georgysb/ZEUS/photo/CPU_bot.jpg

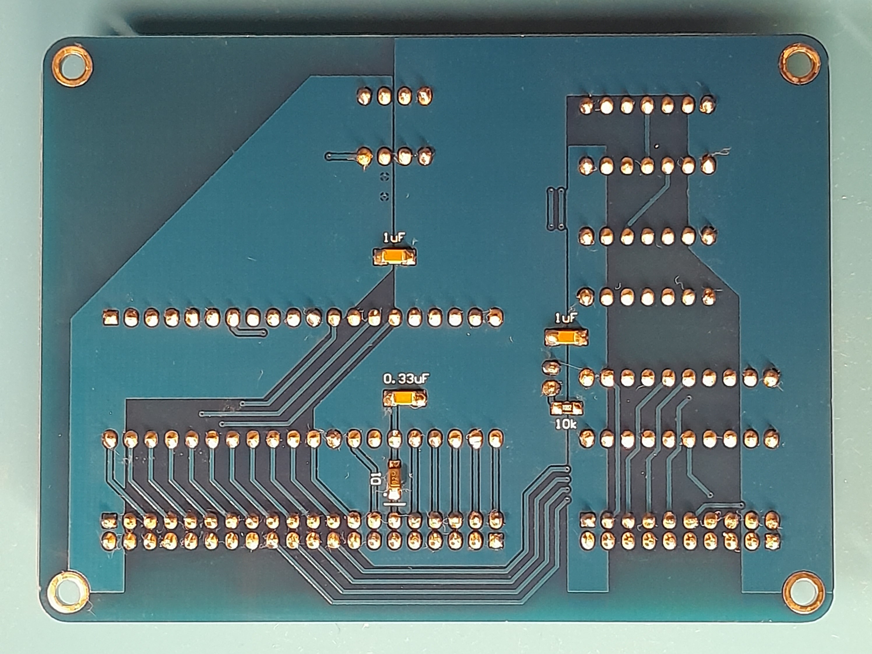
photo/CPU_bot.jpg
