georgysb/ZEUS/photo/backboard_top.jpg

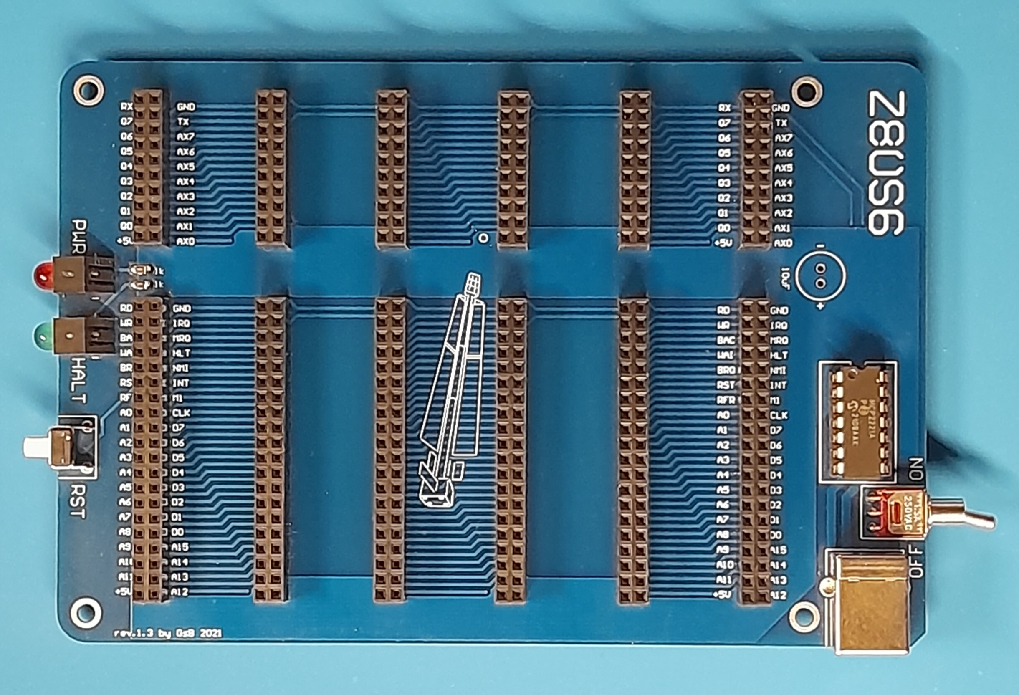
photo/backboard_top.jpg
