georgysb/ZEUS/design/readme.txt

ZEUS system supports up to 4 GPIO modules, provided A2, A3 ports range select jumpers are set differently.

Back board coupler is used to join 2 ZEUS6 back boards into 11 slots system.
