georgysb/ZEUS/ZEUS_monitor/readme.txt

Arduino MEGA code that writes ZEUS Monitor to AT28C256 EEPROM via Arduino MEGA EEPROM programmer shield https://www.tindie.com/products/georgysb/eeprom-dip-28-programmer-shield-for-arduino-mega/.

Be advised, the code is organized in blocks that one can write separately by commenting/decommenting corresponding Arduino code lines (779-804).
