georgysb/ZEUS/design/ZEUS_module_dimensions.png

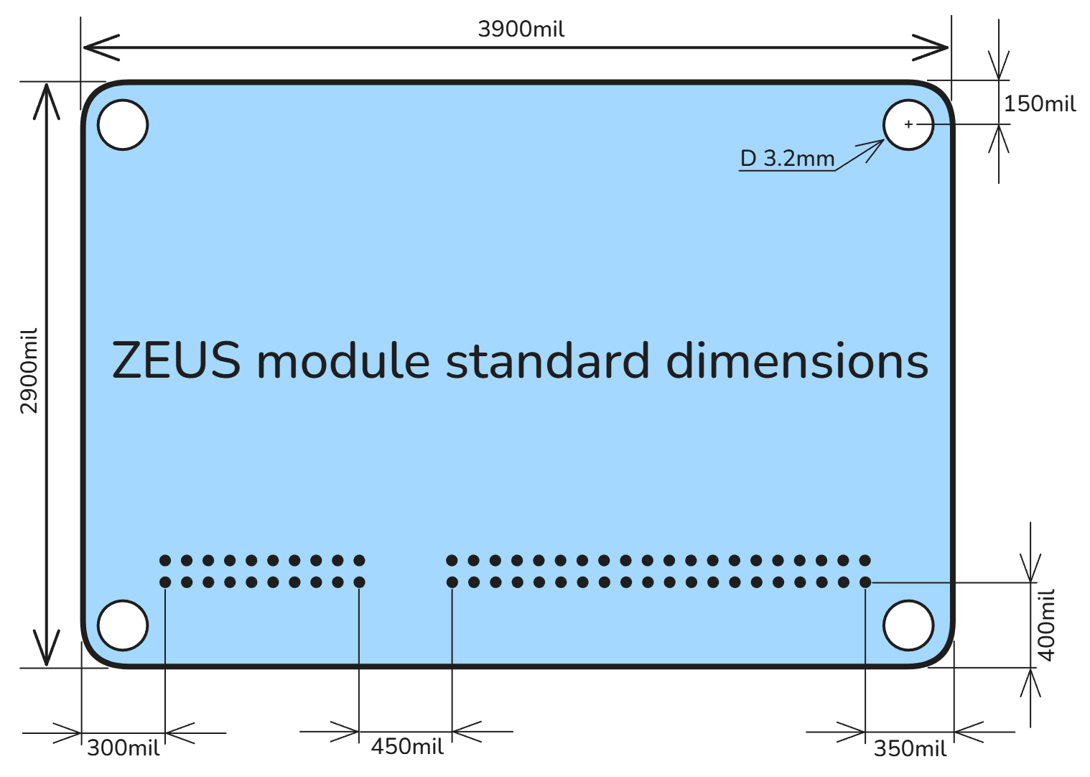
design/ZEUS_module_dimensions.png
