georgysb/ZEUS/photo/backboard_bot.jpg

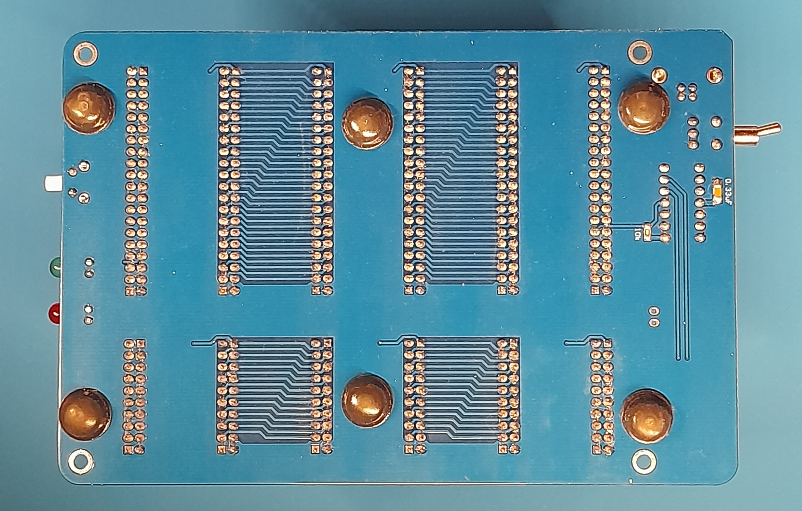
photo/backboard_bot.jpg
