georgysb/ZEUS/photo/coupler.jpg

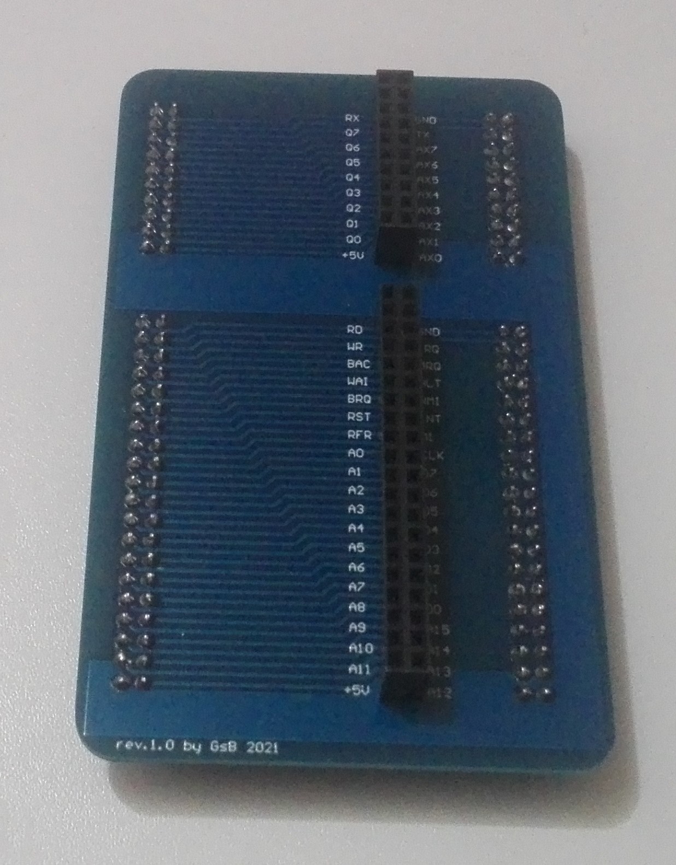
photo/coupler.jpg
