georgysb/ZEUS/photo/CPU_top.jpg

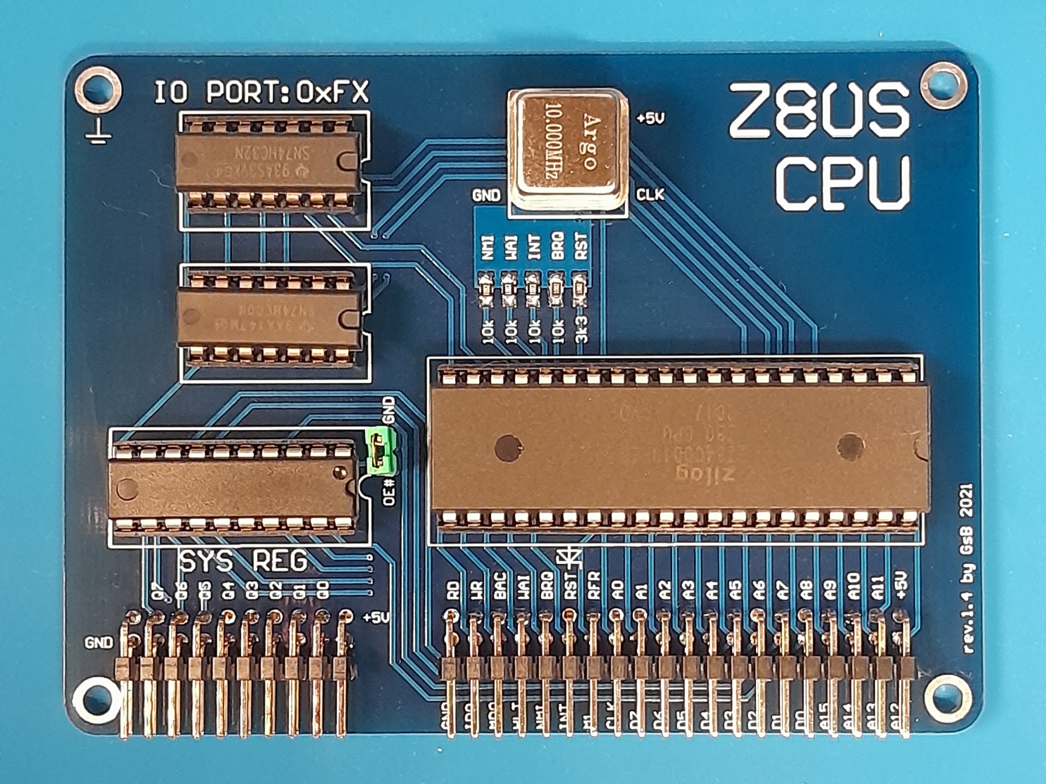
photo/CPU_top.jpg
