georgysb/ZEUS/photo/GPIO_bot.jpg

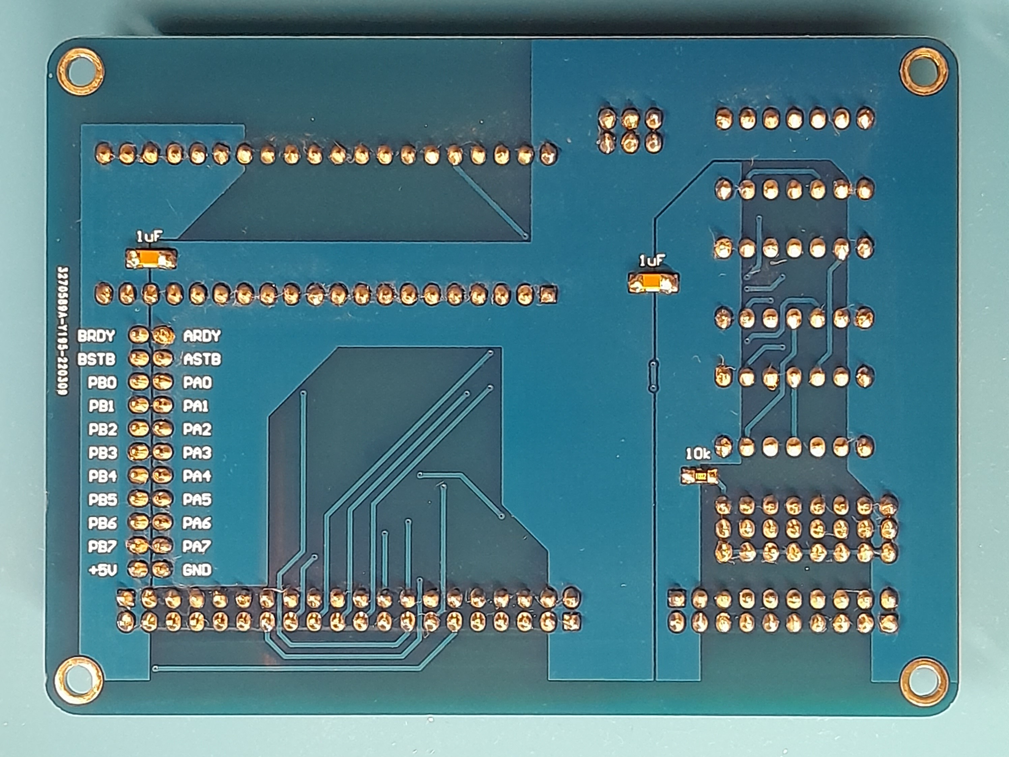
photo/GPIO_bot.jpg
