georgysb/ZEUS/photo/gpio_header.jpg

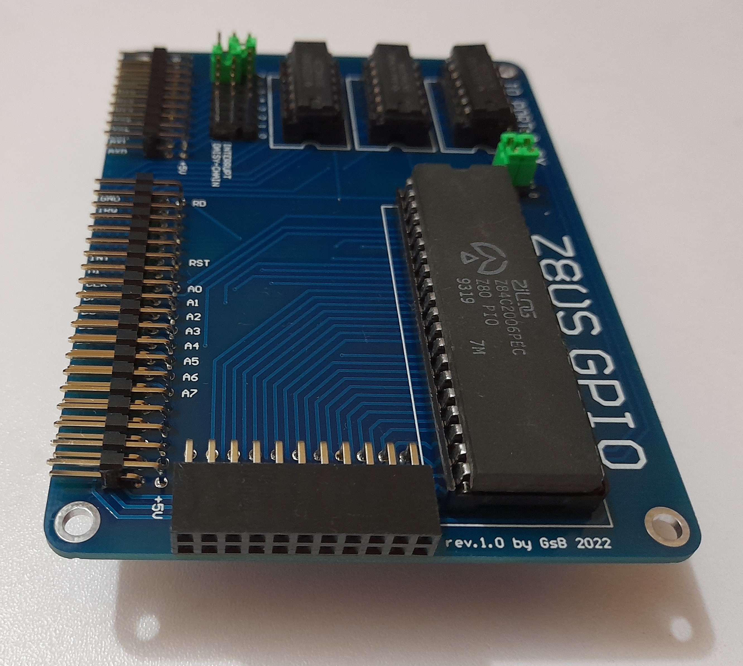
photo/gpio_header.jpg
