georgysb/ZEUS/photo/GPIO_top.jpg

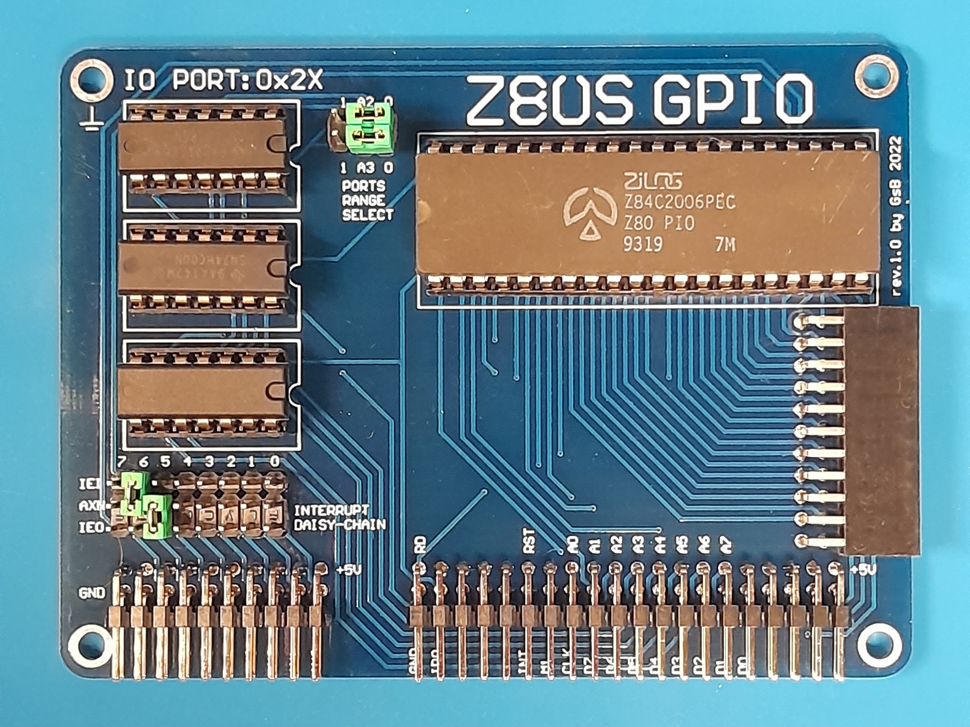
photo/GPIO_top.jpg
