georgysb/ZEUS/photo/MEM128_bot.jpg

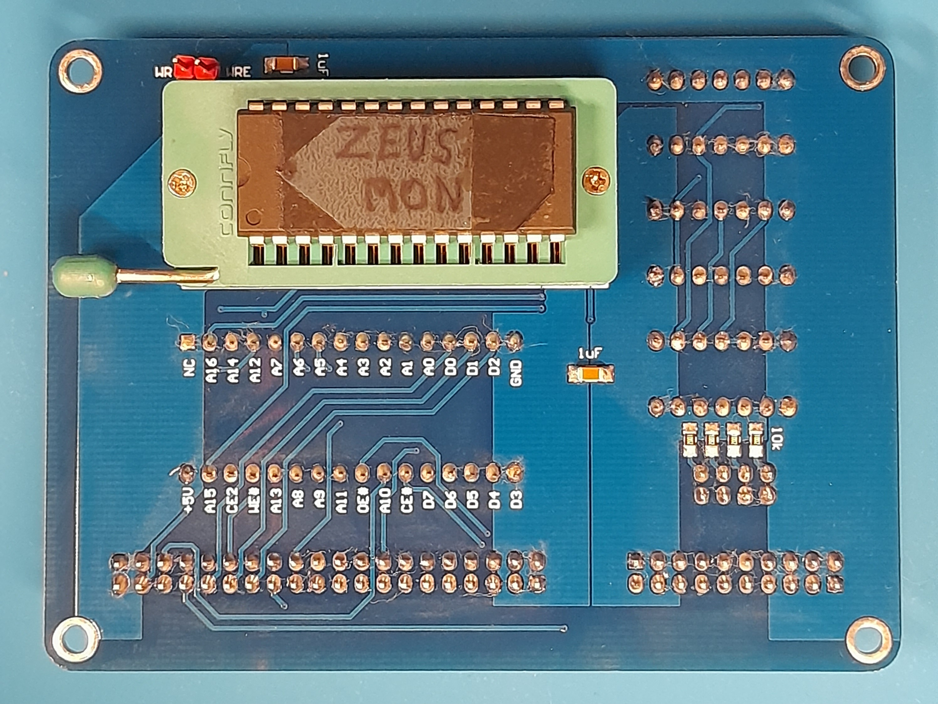
photo/MEM128_bot.jpg
