georgysb/ZEUS/photo/MEM128_top.jpg

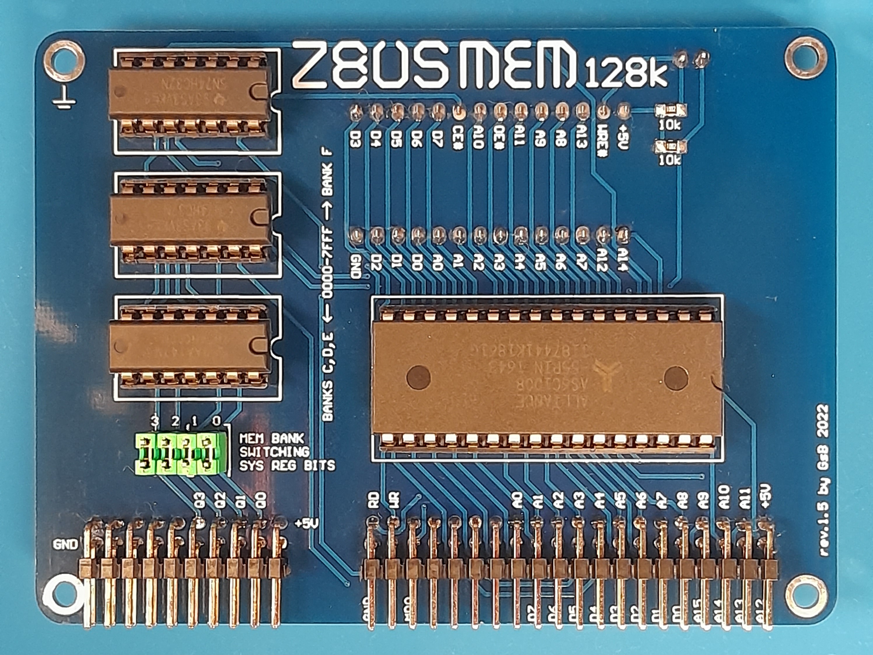
photo/MEM128_top.jpg
