georgysb/ZEUS/photo/MEM512_top.jpg

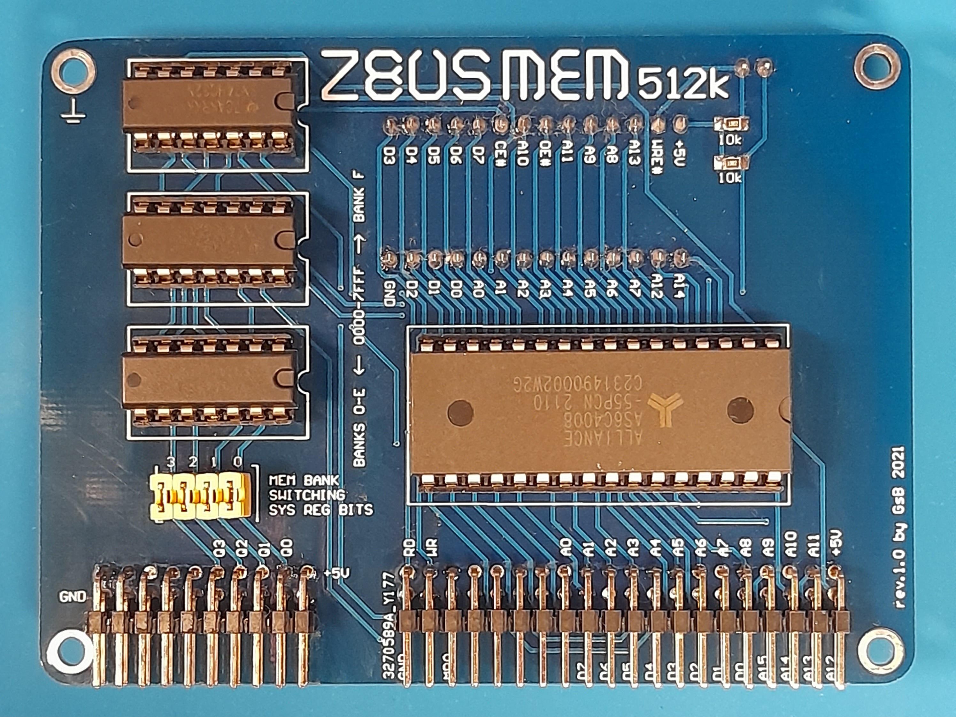
photo/MEM512_top.jpg
