georgysb/ZEUS/photo/PIO_bot.jpg

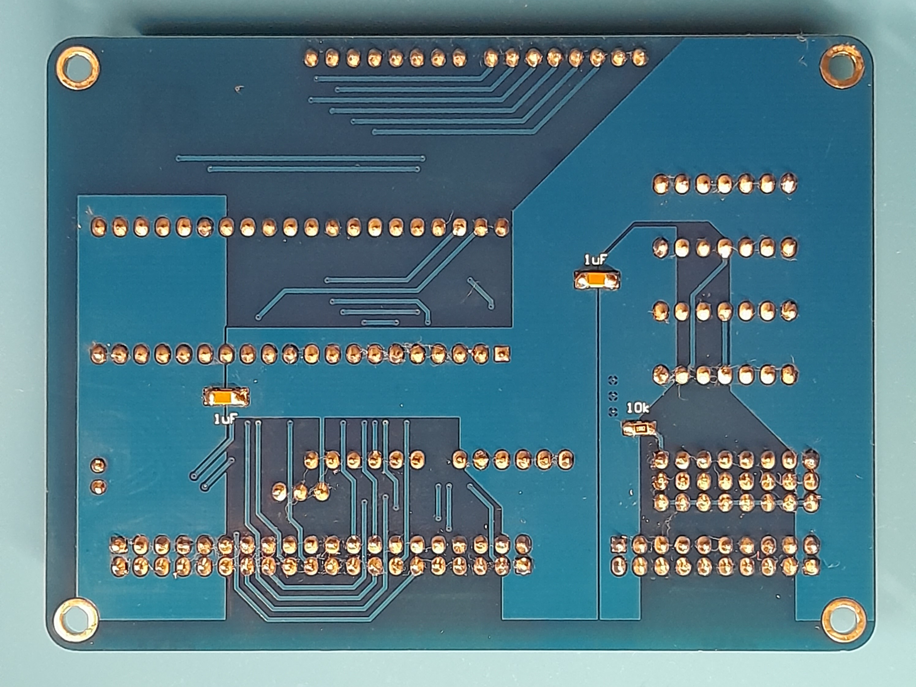
photo/PIO_bot.jpg
