georgysb/ZEUS/photo/PIO_top.jpg

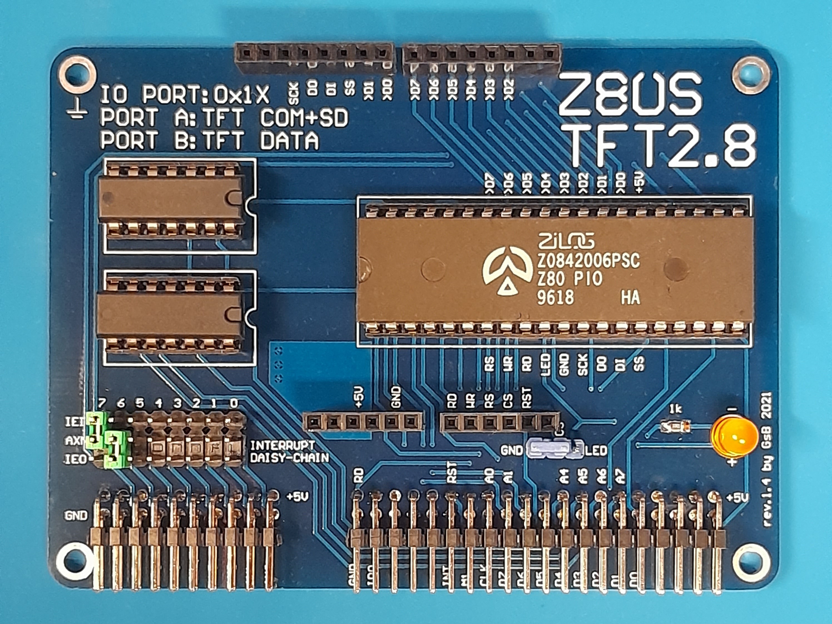
photo/PIO_top.jpg
