georgysb/ZEUS/photo/prog_side.jpg

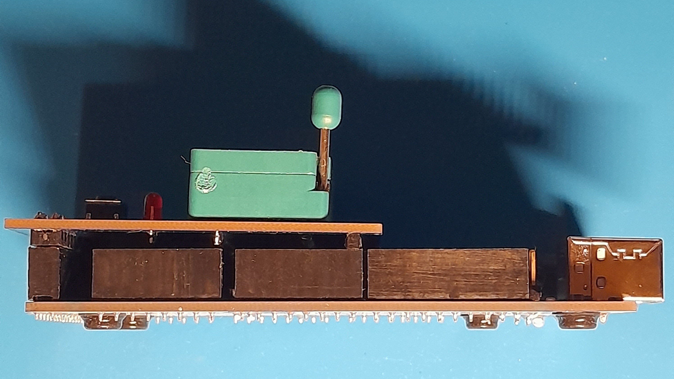
photo/prog_side.jpg
