georgysb/ZEUS/photo/prog_top.jpg

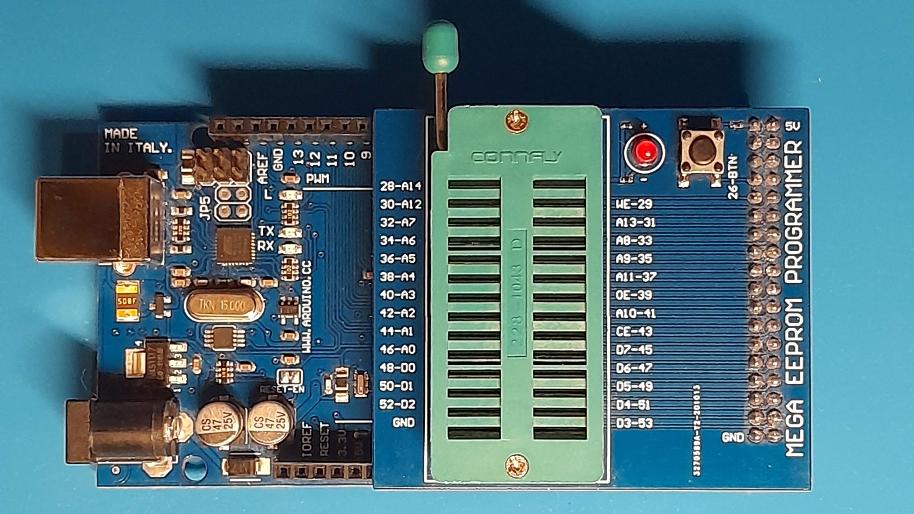
photo/prog_top.jpg
