georgysb/ZEUS/photo/SIO_bot.jpg

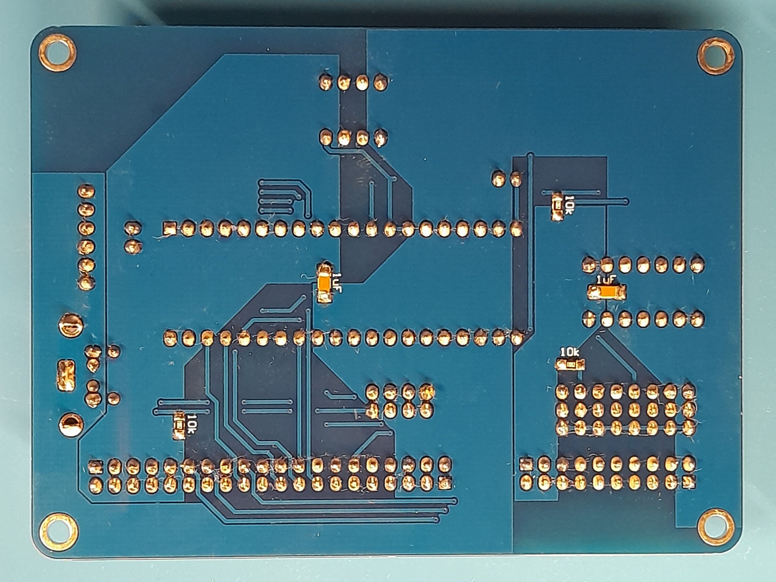
photo/SIO_bot.jpg
