georgysb/ZEUS/photo/SIO_top.jpg

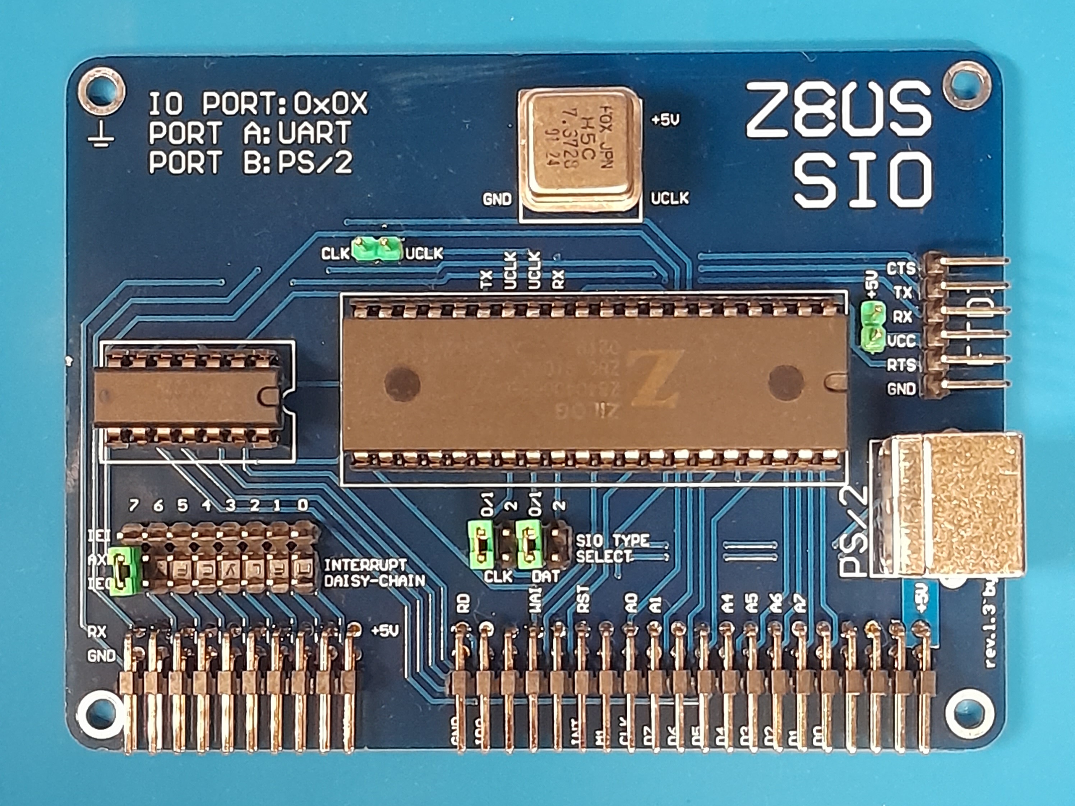
photo/SIO_top.jpg
