georgysb/ZEUS/photo/TFT_bot.jpg

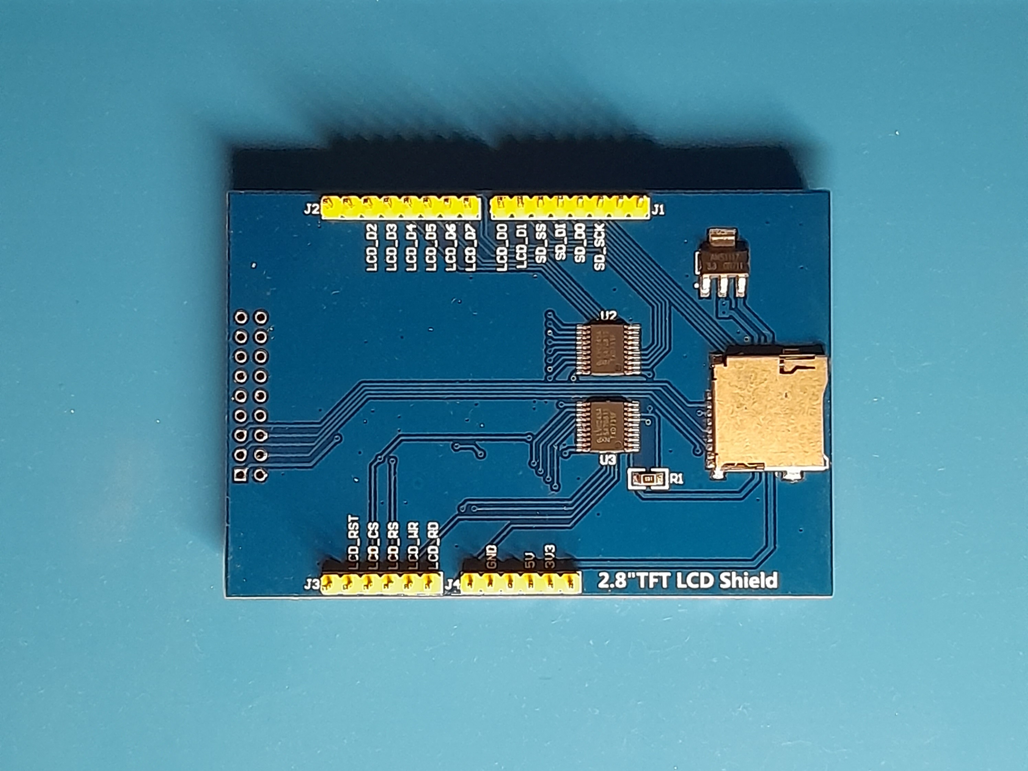
photo/TFT_bot.jpg
