georgysb/ZEUS/photo/TFT_top.jpg

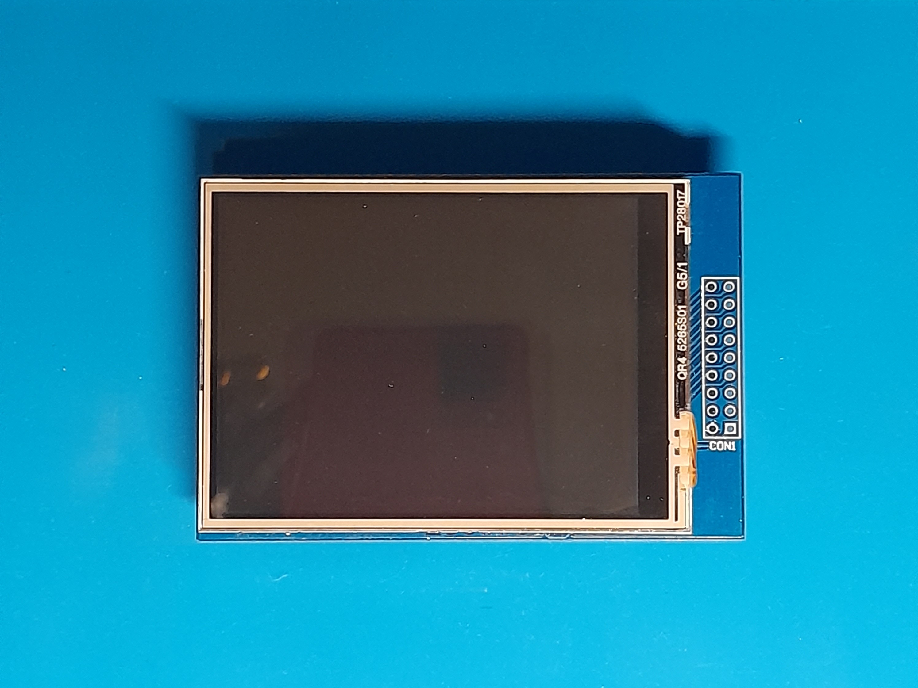
photo/TFT_top.jpg
