georgysb/ZEUS/photo/zeus+gpio_function.jpg

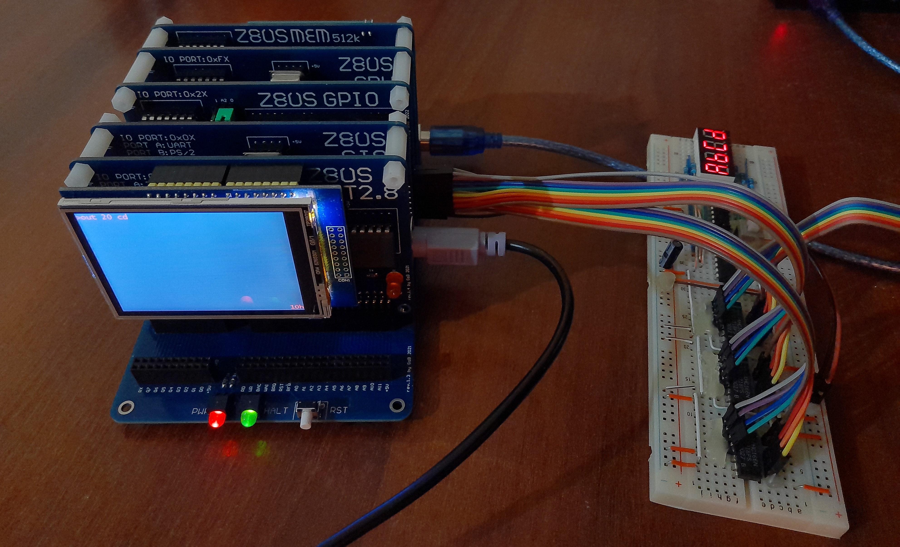
photo/zeus+gpio_function.jpg
