georgysb/ZEUS/photo/zeus_back.jpg

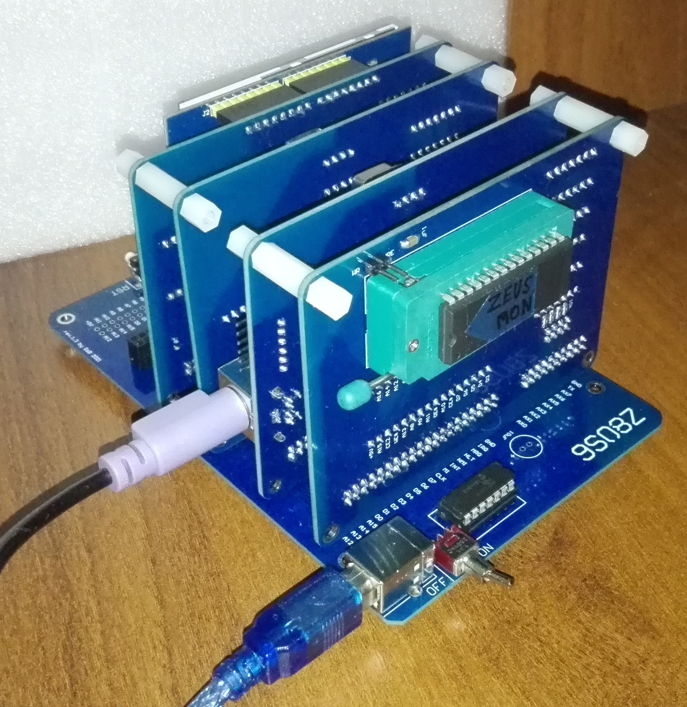
photo/zeus_back.jpg
