georgysb/ZEUS/photo/zeus_front.jpg

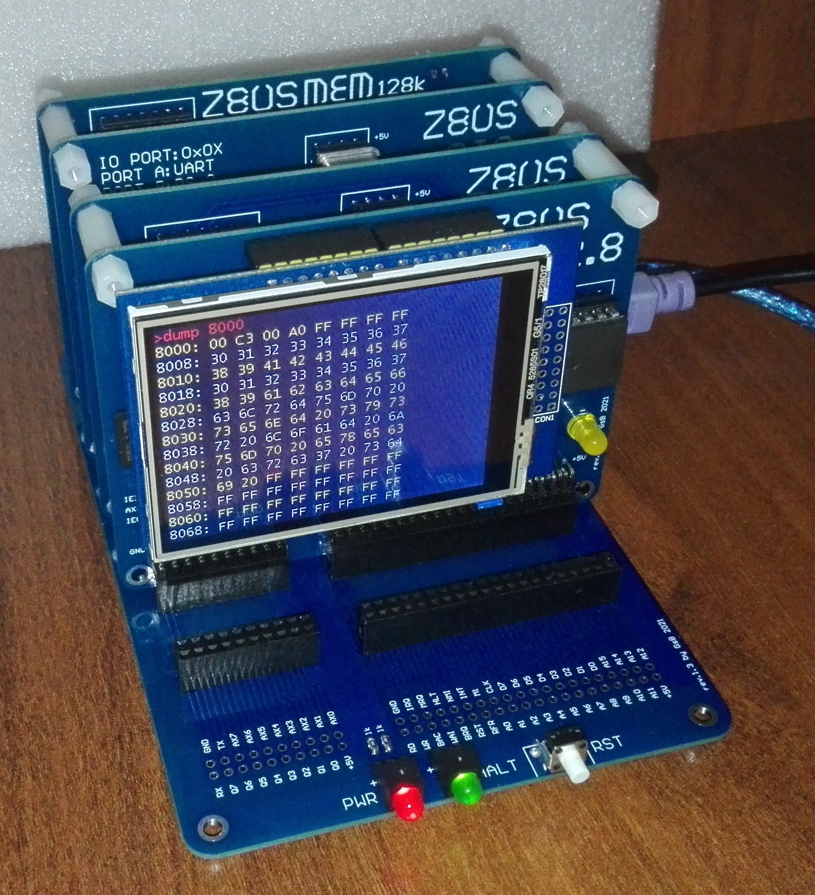
photo/zeus_front.jpg
