georgysb/ZEUS/photo/zeus_highZ.jpg

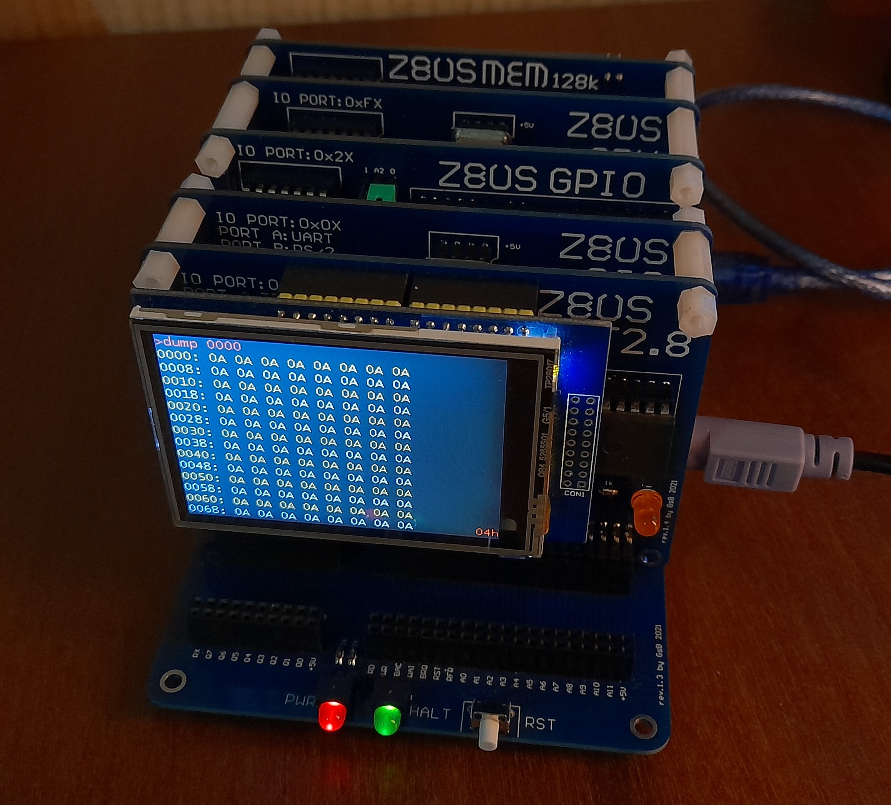
photo/zeus_highZ.jpg
