georgysb/ZEUS/photo/zeus_side.jpg

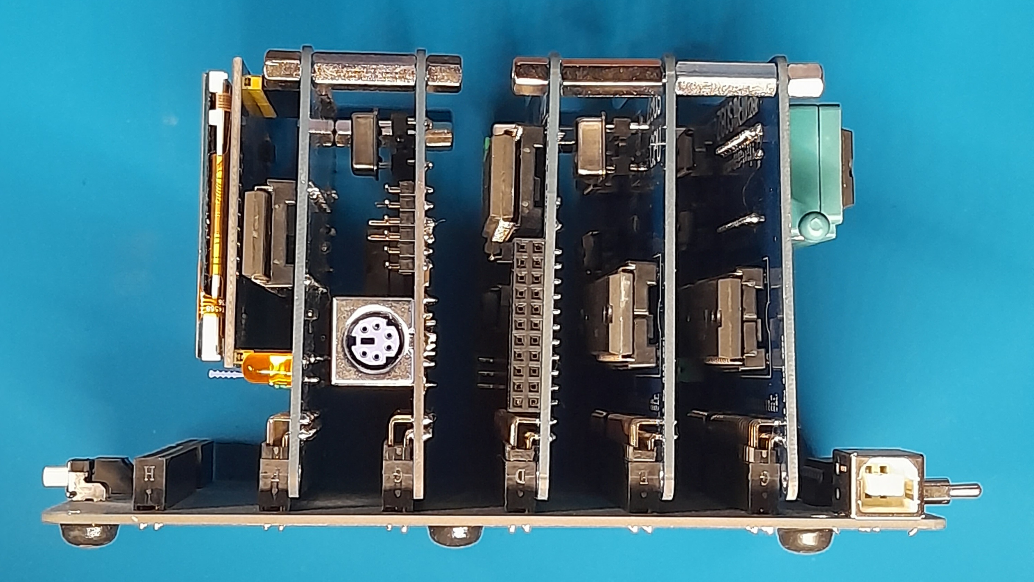
photo/zeus_side.jpg
