georgysb/ZEUS/photo/zeus_top.jpg

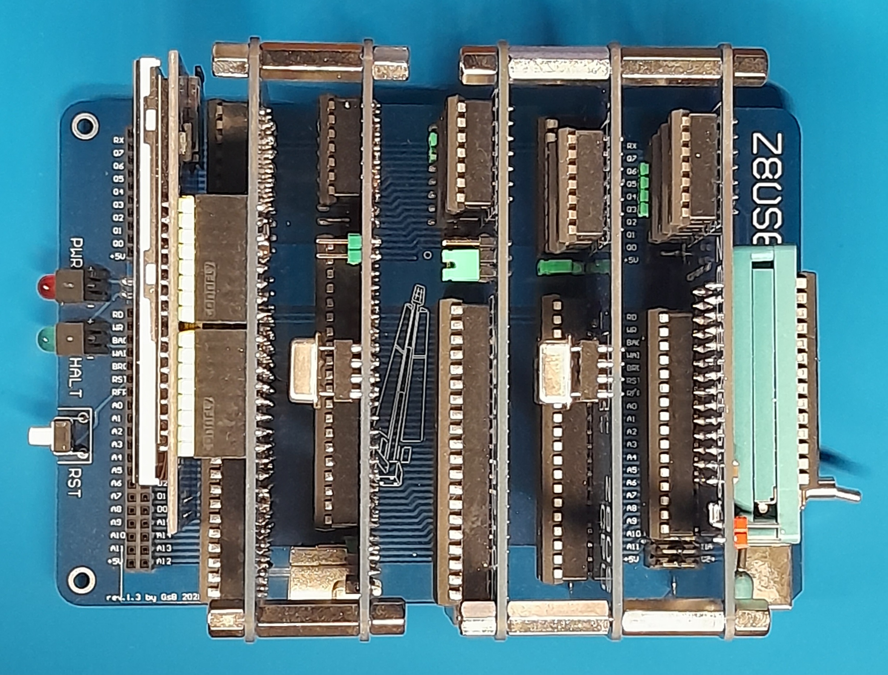
photo/zeus_top.jpg
