georgysb/ZEUS/zeus_BOM.txt

----------------------------------ZEUS6 (backboard)
6x	PBD-40 header
6x	PBD-20 header
1x	USB socket (type B)
1x	SPDT switch (SMTS-102-2C3)
1x	Tact switch R (1-1825027-7)
1x	LED R red (L-1503CB/1ID)
1x	LED R green (L-1503CB/1GD)
1x	dil-14 narrow socket
1x	electrolytic capacitor 10uF (optional)
1x	SMD capacitor 1uF(1206)
1x	SMD resistor 10k(0805)
2x	SMD resistor 1k(0805)
6x	rubber foot

1x	MCP2221A (USB-UART bridge) dip-14

----------------------------------ZEUS CPU (module)
1x	PLD-40R header
1x	PLD-20R header
1x	dil-40 wide socket
1x	dil-20 narrow socket
2x	dil-14 narrow socket
1x	dil-8 narrow collet socket (for quartz generator)
1x	PLS-2 (jumper)
3x	SMD capacitor 1uF(1206)
6x	SMD resistor 10k(0805)
1x	SMD shottky diod

1x	Z84C0010PEG (CPU) dip-40
1x	DM74LS374N (flip-flop) dip-20
1x	SN74HC32N (OR gate) dip-14
1x	SN74HC00N (NAND gate) dip-14
1x	10MHz (clock generator) dil-8

----------------------------------ZEUS MEM128k/512k (module)
1x	PLD-40R header
1x	PLD-20R header
1x	ZIF-28 wide socket (DS1043-280G Connfly)
1x	dil-32 wide socket
3x	dil-14 narrow socket
1x	PLS-2 (jumper)
1x	PLD-8 (jumper header)
2x	SMD capacitor 1uF(1206)
6x	SMD resistor 10k(0805)

1x	AT28C256-15PU (EEPROM 32kB) dip-28 (or FM1808-70-P for 10MHz in situ write capability)
1x	AS6C1008/AS6C4008 (SRAM 128k/512k) dip-32
2x	SN74HC32N (OR gate) dip-14
1x	SN74HC00N (NAND gate) dip-14

----------------------------------ZEUS SIO (module)
1x	PLD-40R header
1x	PLD-20R header
1x	dil-40 wide socket
1x	dil-14 narrow socket
1x	dil-8 narrow collet socket (for quartz generator)
2x	PLS-2 (jumper)
1x	PLD-8 (jumper header)
1x	PLD-16 (jumper header)
1x	PLS-8 (jumper header)
1x	PLS-6R(FTDI header)
2x	SMD capacitor 1uF(1206)
3x	SMD resistor 10k(0805)
1x	PS/2 socket

1x	Z84C4006PEC (SIO) dip-40
1x	SN74HC32N (OR gate) dip-14
1x	7.3728MHz (clock generator) dil-8

----------------------------------ZEUS TFT2.8 (module)
1x	PLD-40R header
1x	PLD-20R header
1x	dil-40 wide socket
2x	dil-14 narrow socket
1x	PLD-16 (jumper header)
1x	PLS-8 (jumper header)
1x	PLS-3 (jumper header)
2x	PBS-8 (TFT shield header)
2x	PBS-6 (TFT shield header)
1x	LED orange
2x	SMD capacitor 1uF(1206)
1x	SMD resistor 10k(0805)
1x	SMD resistor 1k(0805)

1x	Z0842006PSC (PIO) dip-40
1x	SN74HC32N (OR gate) dip-14
1x	SN74HC00N (NAND gate) dip-14
1x	ARDUINO UNO SHIELD TFT2.8" 320x240 (ILI9341)

----------------------------------ZEUS GPIO (module)
1x	PLD-40R header
1x	PLD-20R header
1x	PBD-22R header
1x	dil-40 wide socket
3x	dil-14 narrow socket
1x	PLD-16 (jumper header)
1x	PLS-8 (jumper header)
1x	PLD-6 (jumper header)
2x	SMD capacitor 1uF(1206)
1x	SMD resistor 10k(0805)

1x	Z0842006PSC (PIO) dip-40
1x	SN74HC32N (OR gate) dip-14
1x	SN74HC00N (NAND gate) dip-14
1x	SN74HC86N (XOR gate) dip-14

----------------------------------EEPROM-28pin Arduino MEGA programmer shield
1x	ZIF-28 wide socket (DS1043-280G Connfly)
1x	LED red
1x	Tact switch SMD 6х6мм
1x	SMD resistor 10k(0805)
1x	SMD resistor 1k(0805)

----------------------------------ZEUS coupler
1x	PBD-40 header
1x	PBD-20 header
2x	PLD-40 header (straight)
2x	PLD-20 header (straight)

----------------------------------MISC
10x	jumper 6mm
1x	jumper 13.7mm blue
1x	jumper 13.7mm red

4x	M3 spacer M-F 15mm
2x	M3 spacer F-F 20mm
4x	M3 spacer M-F 6mm
4x	M3 spacer F-F 6mm
