georgysb/ZEUS/schematics/zeus backboard schem.pdf

+5V

## GND

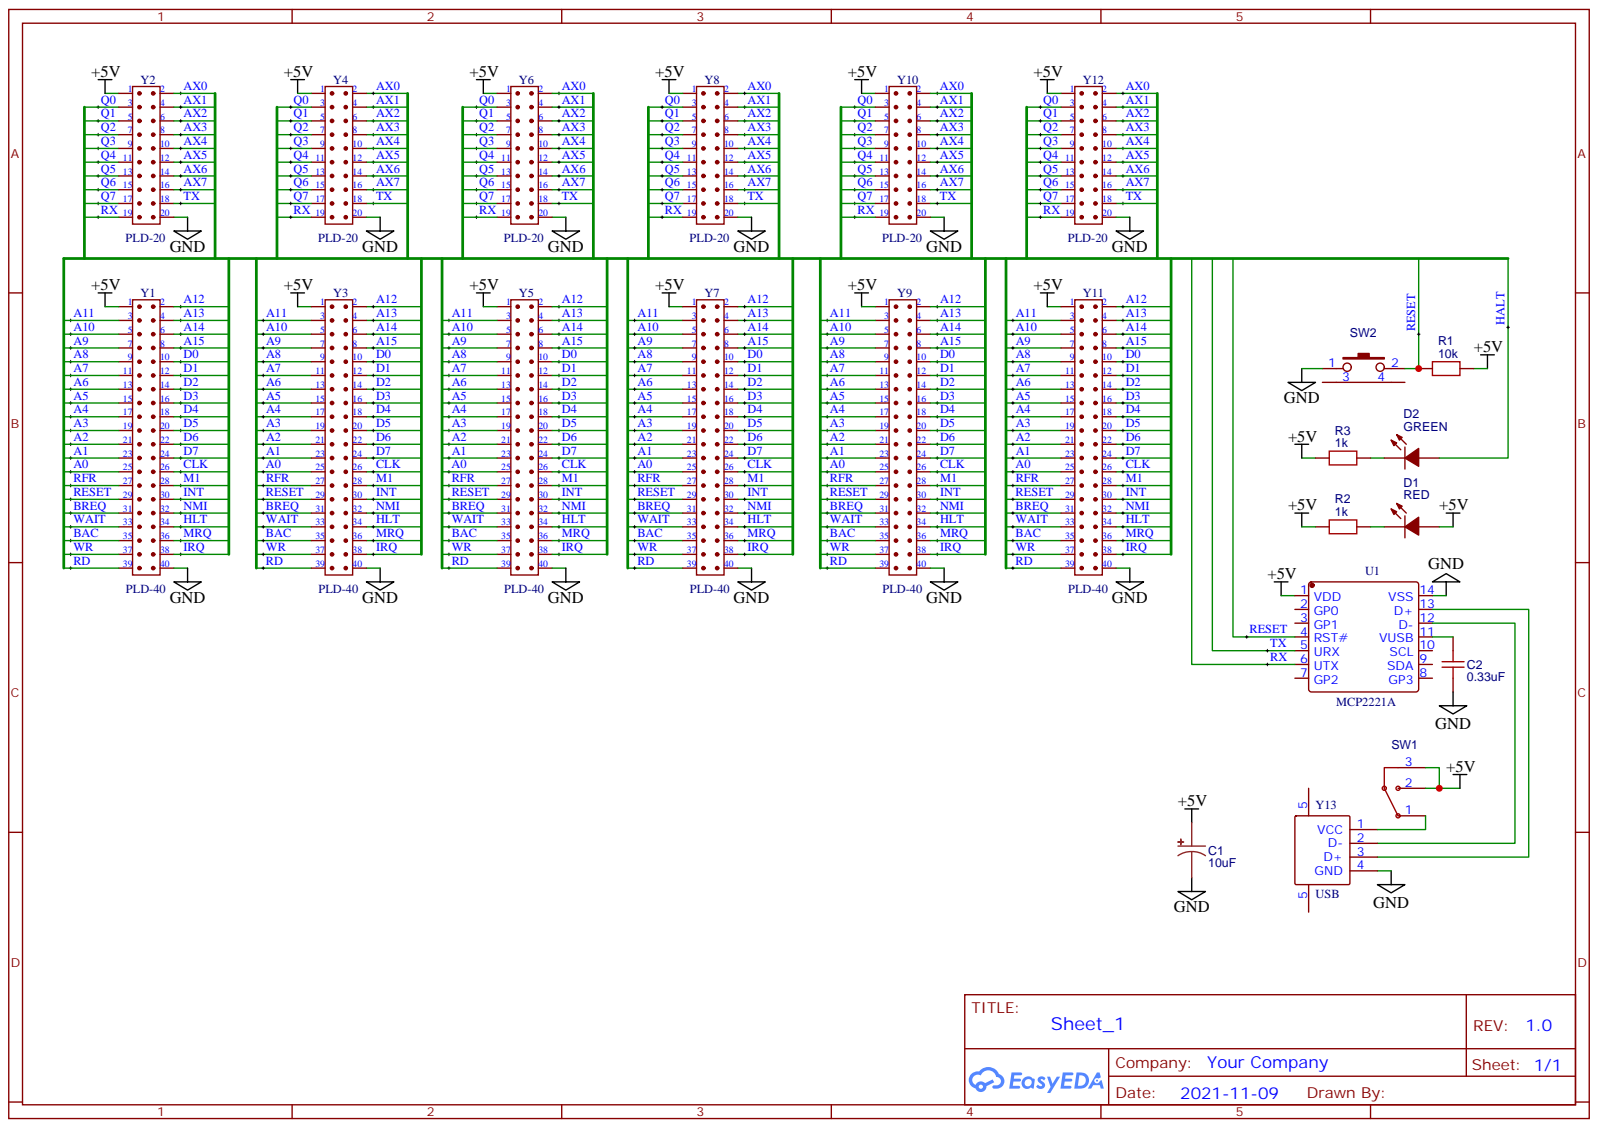
[picture p45: page 1]
