georgysb/ZEUS/schematics/zeus mem128_1.5 schem.pdf

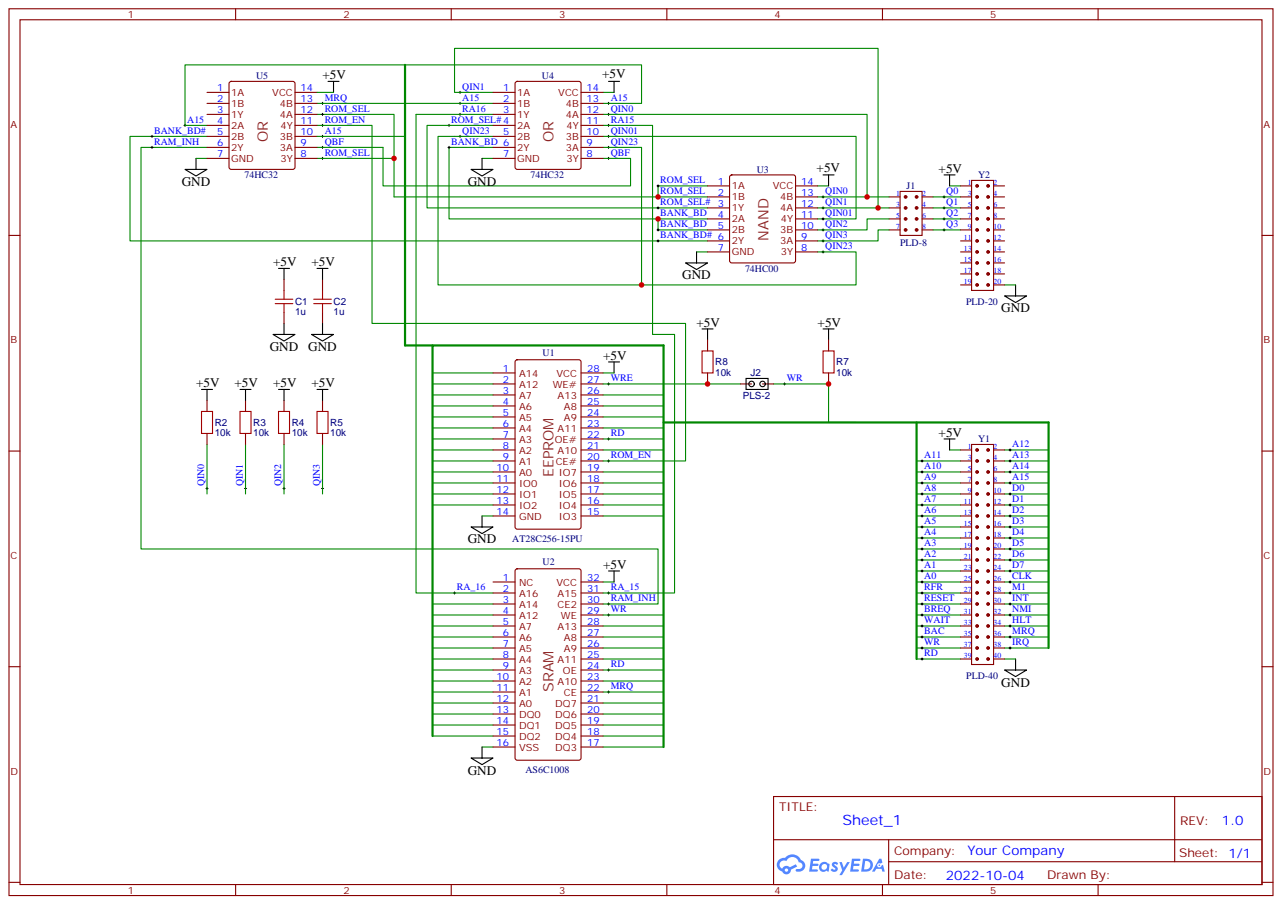
[picture p46: page 1]
