georgysb/ZEUS/schematics/zeus mem128_1.4 schem.pdf

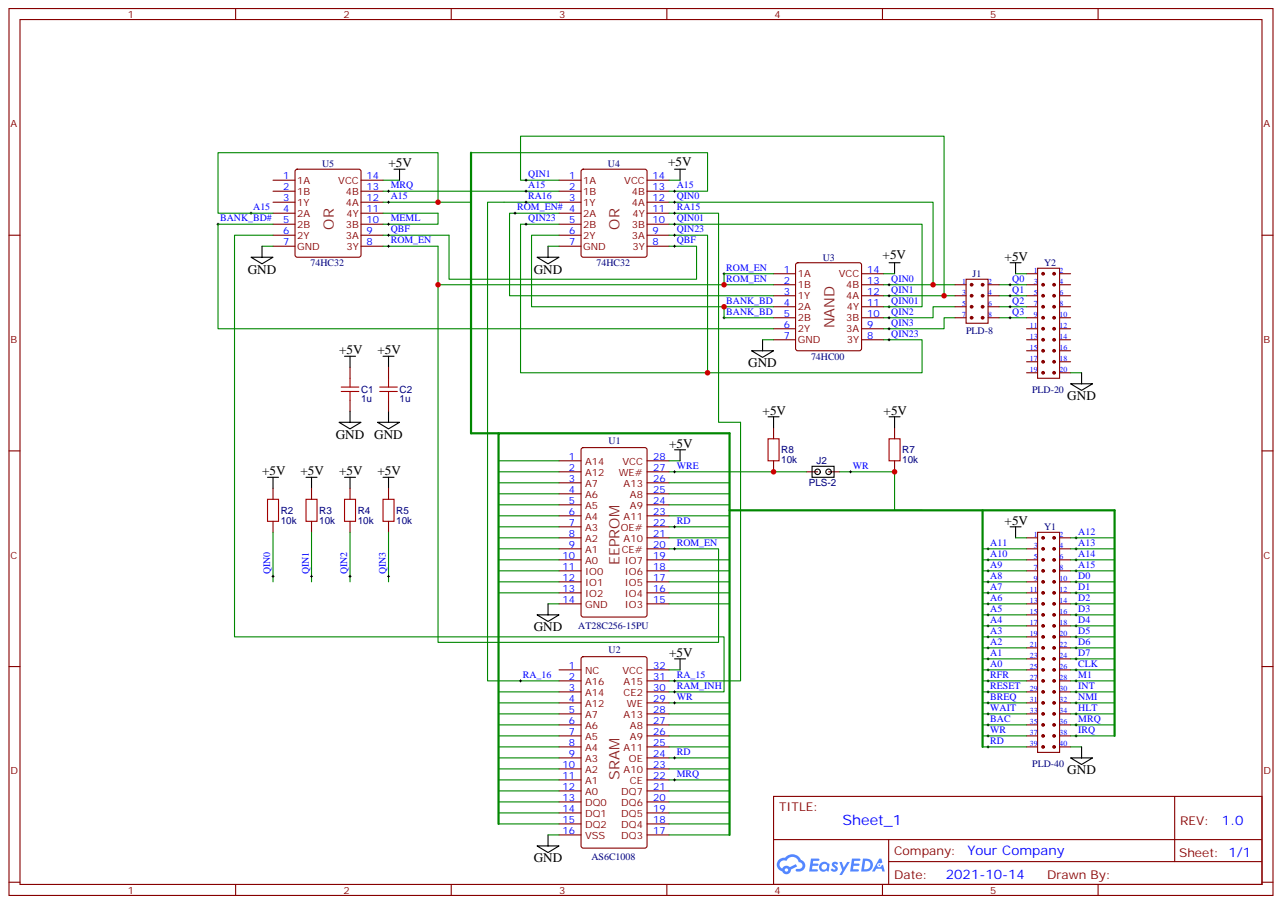
[picture p47: page 1]
