georgysb/ZEUS/schematics/zeus gpio schem.pdf

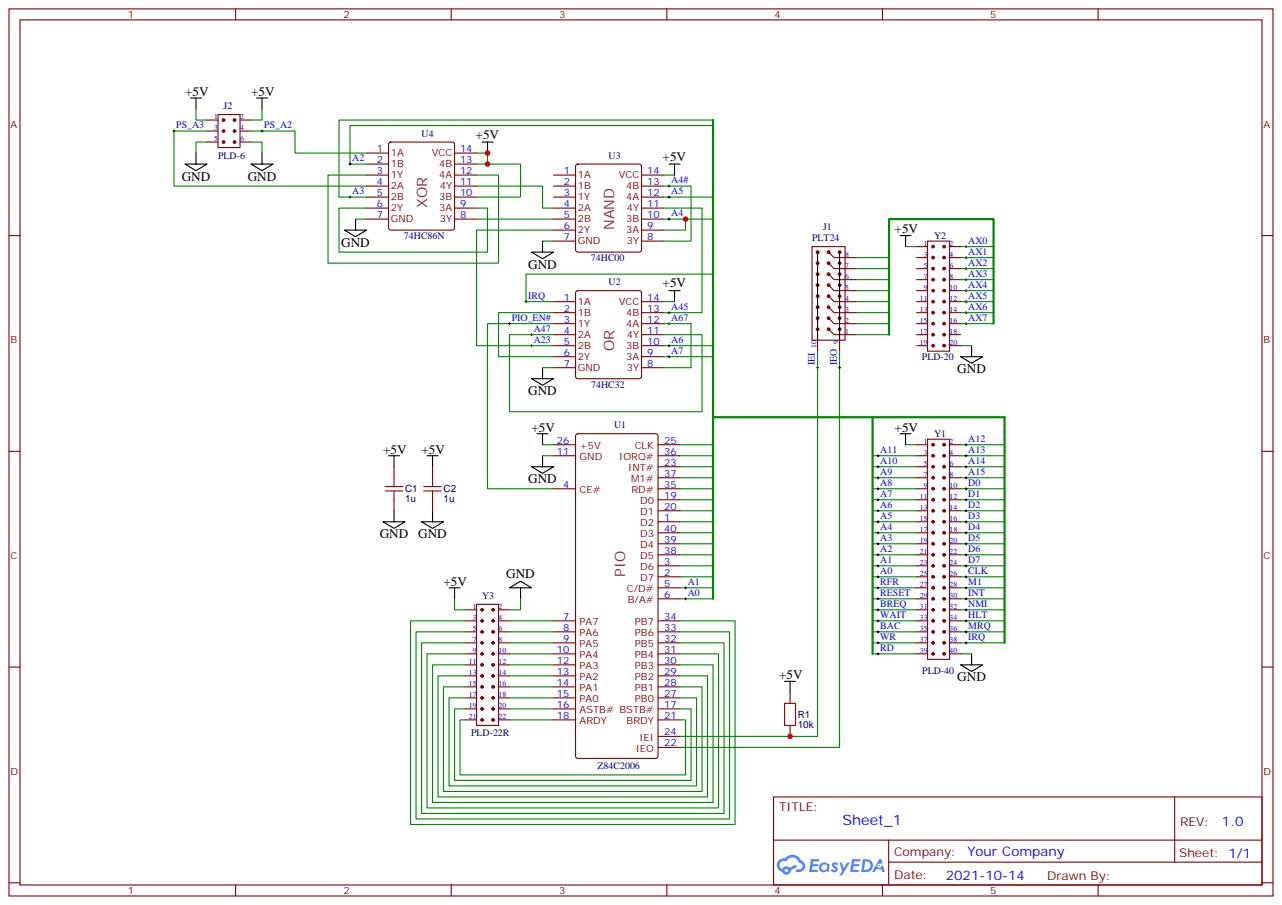
[picture p48: page 1]
