georgysb/ZEUS/schematics/zeus mem512 schem.pdf

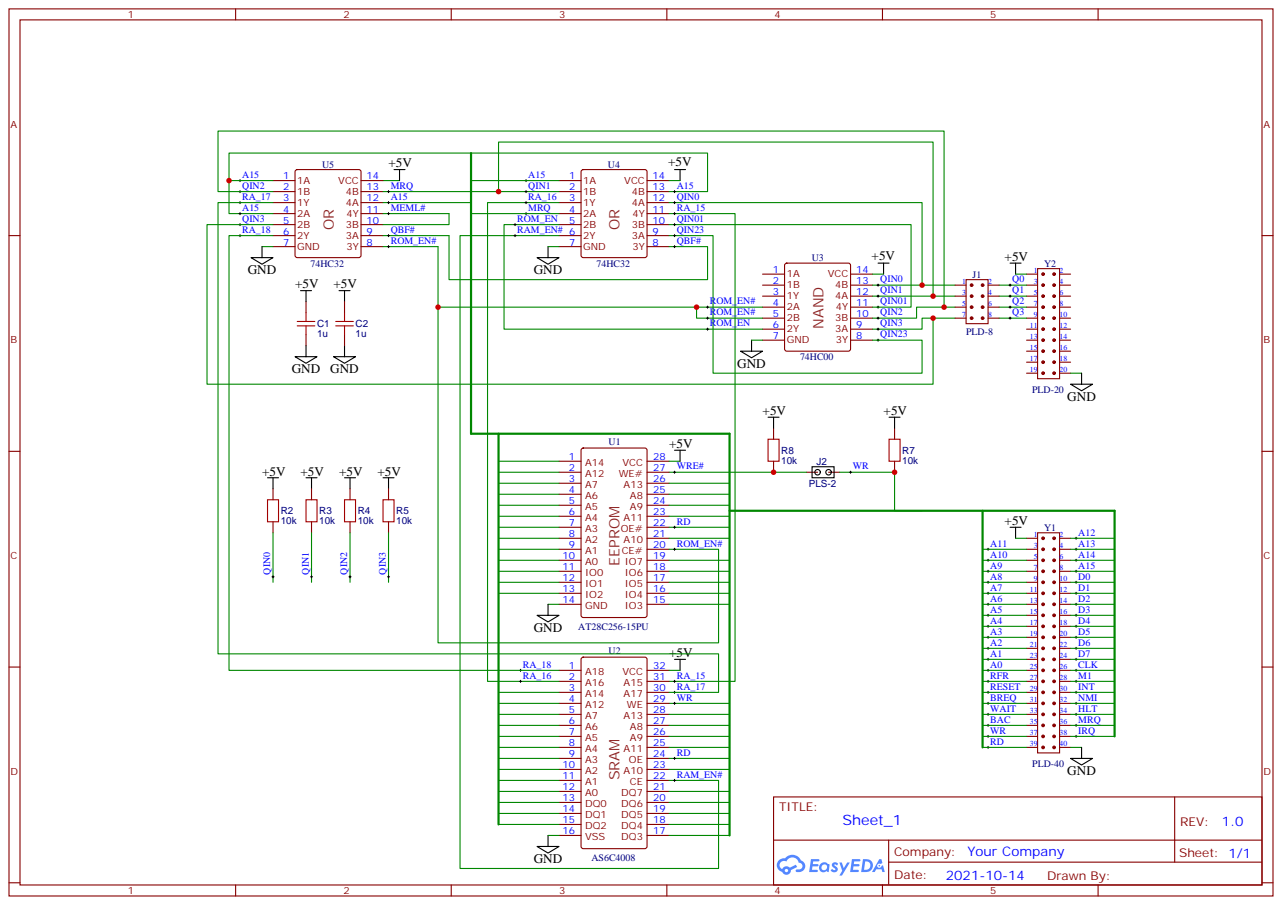
[picture p49: page 1]
