georgysb/ZEUS/schematics/zeus cpu schem.pdf

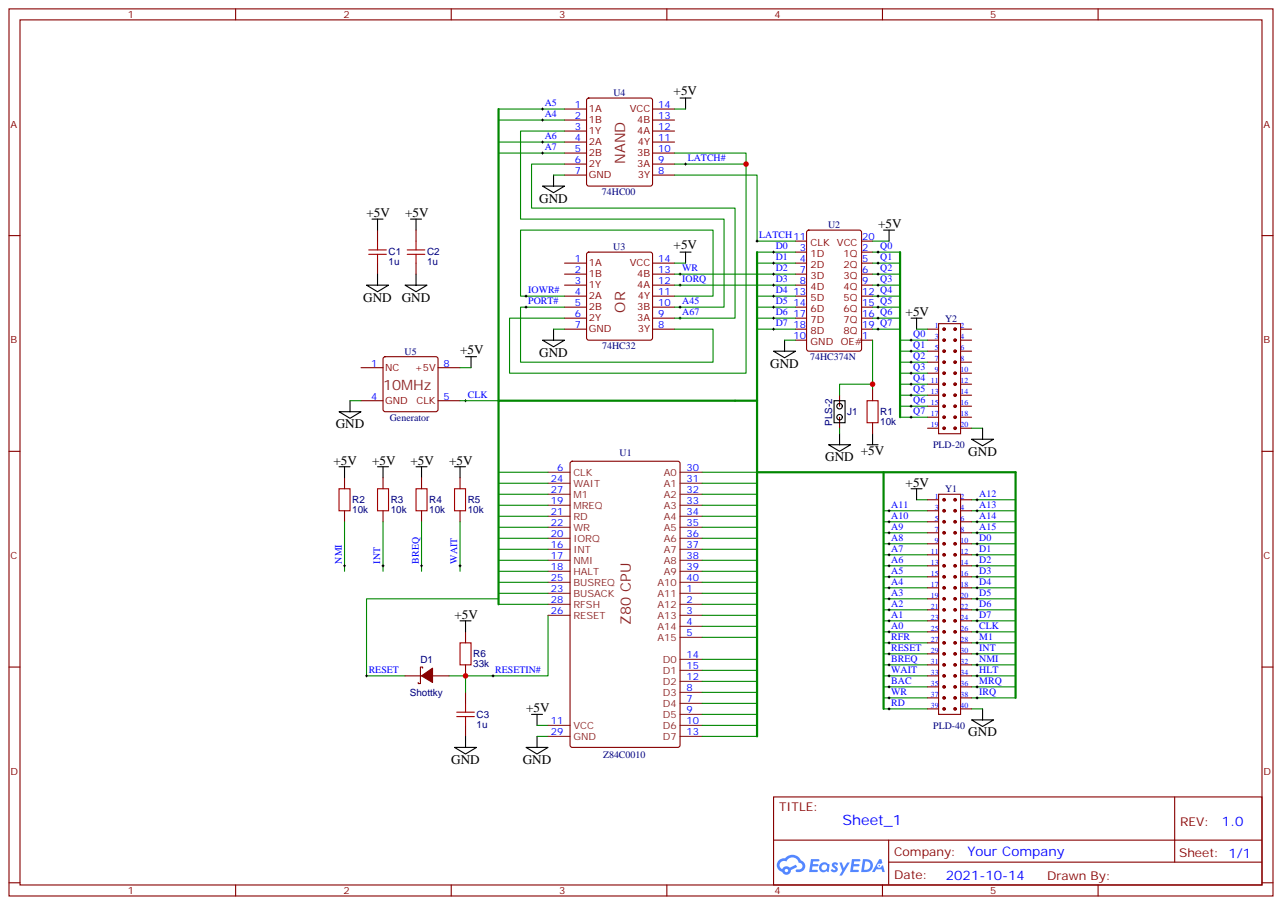
[picture p50: page 1]
