georgysb/ZEUS/schematics/zeus mem128_1.3 schem.pdf

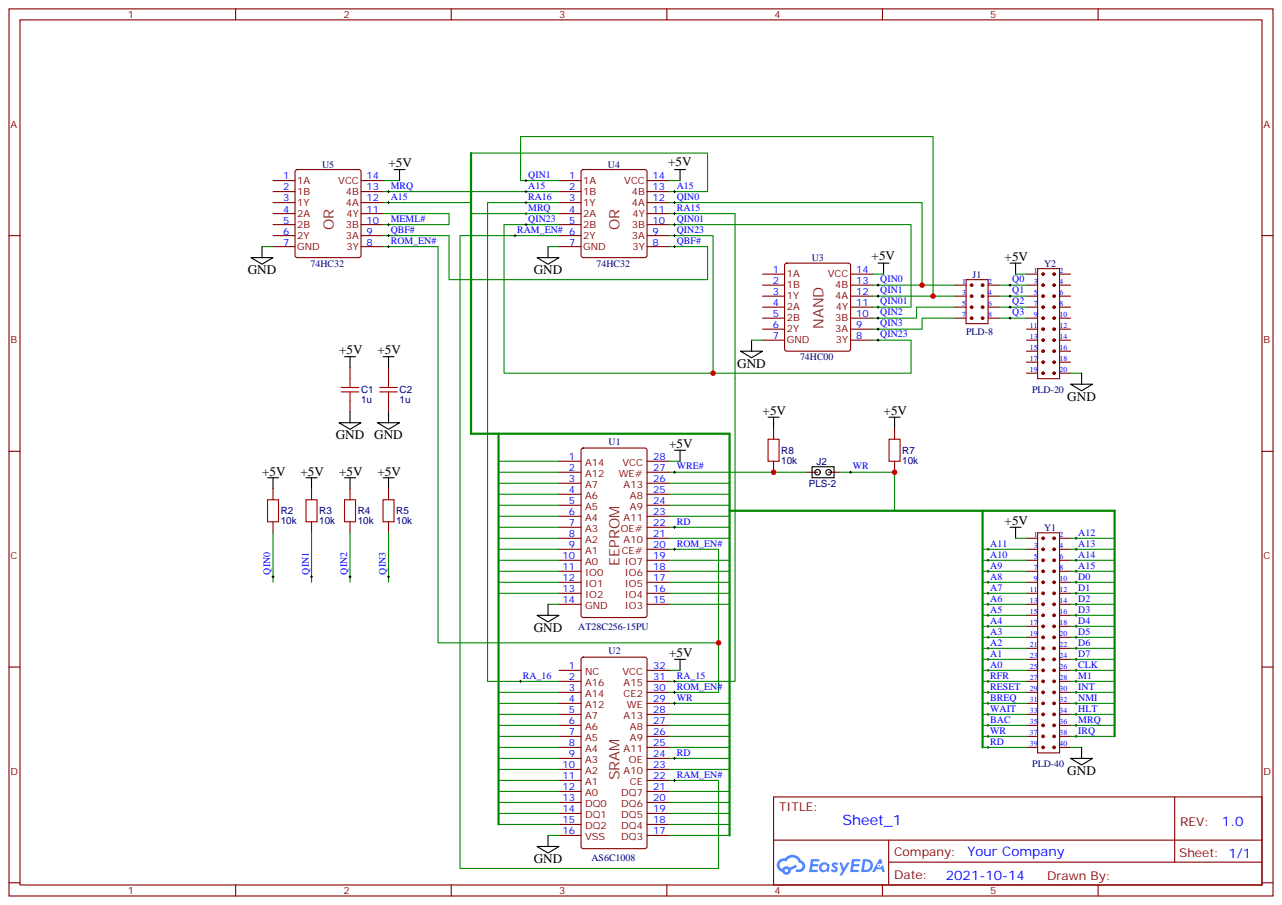
[picture p51: page 1]
