georgysb/ZEUS/schematics/zeus sio schem.pdf

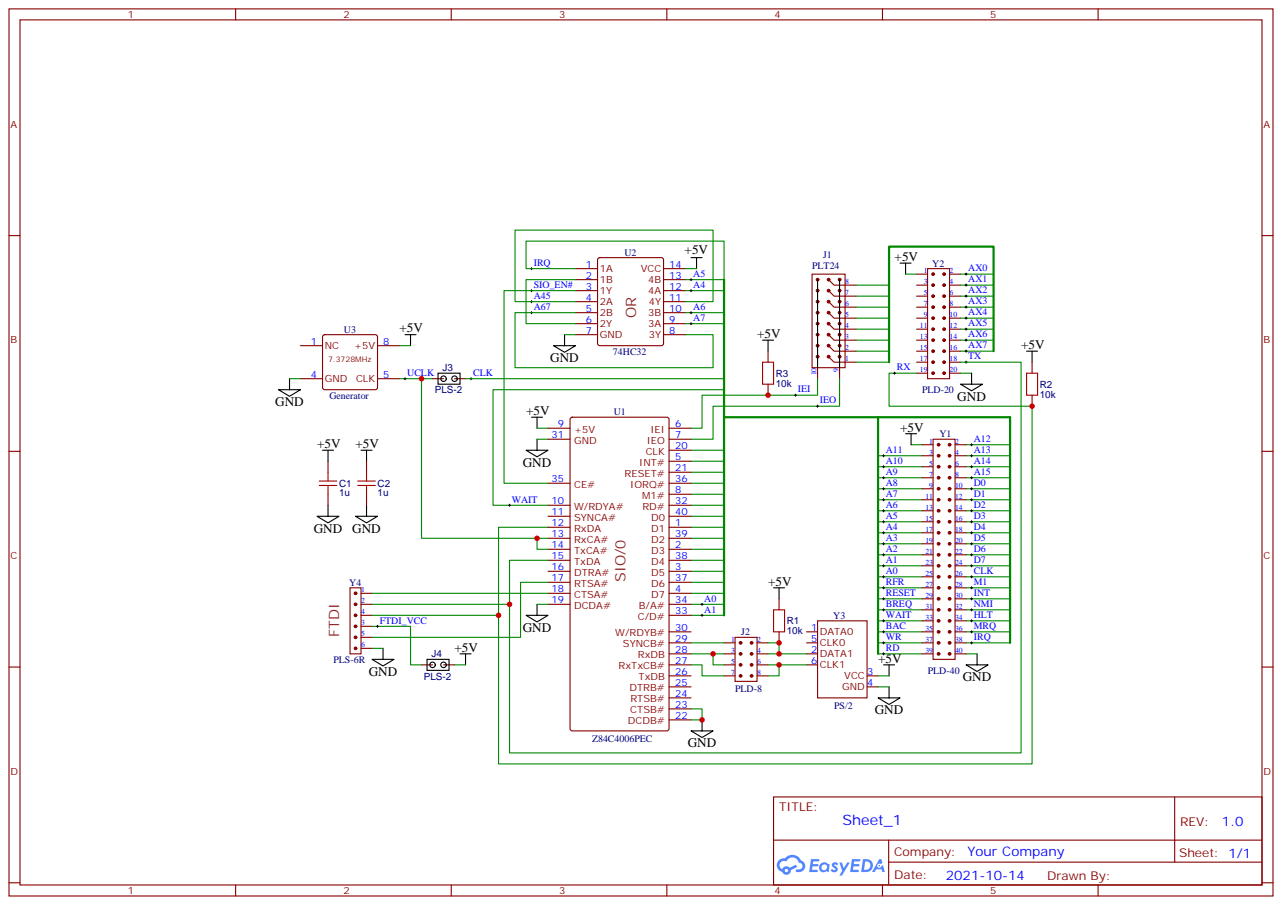
[picture p52: page 1]

DCDB# 22 CTSB# 23 RTSB# 24 DTRB# 25 TxDB 26 RxTxCB# 27 RxDB 28 SYNCB# 29 W/RDYB# 30
