georgysb/ZEUS/schematics/zeus tft2.8 schem.pdf

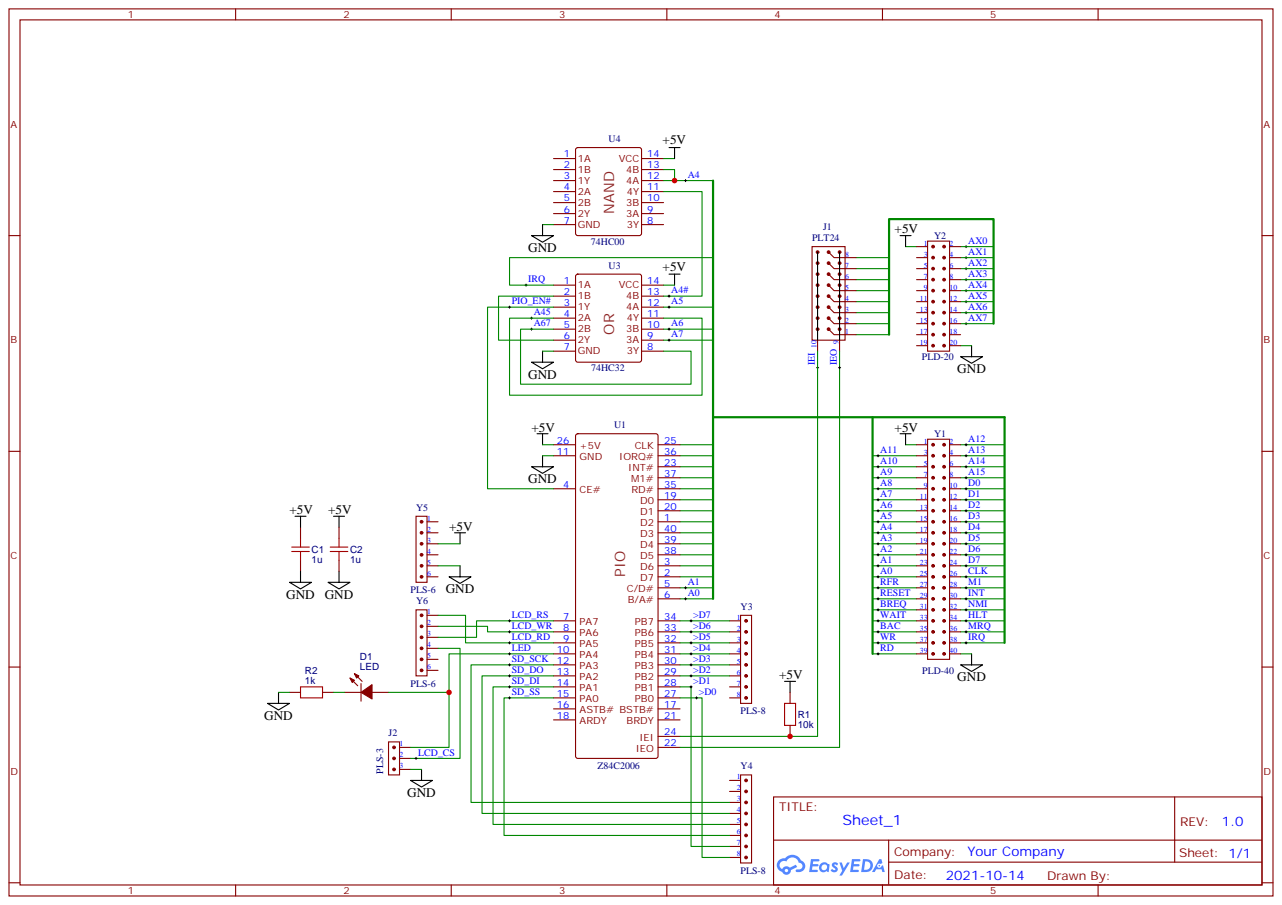
[picture p53: page 1]
