georgysb/ZEUS/ZEUS_monitor/ZEUS_monitor.ino

uint16_t offset_font = 0x0200;
const byte FONT_TABLE[] = {
 0x00,0x00,0x00,0x00,0x00,0x00,0x00,0x00,0x00,0x00,0x00,0x00,0x00,0x00,0x00,0x00,
 0x00,0x00,0x00,0x00,0x00,0x3C,0x42,0xA5,0x81,0xBD,0x42,0x3C,0x00,0x00,0x00,0x00,
 0x00,0x00,0x00,0x00,0x00,0x3C,0x7E,0xDB,0xFF,0xDB,0x42,0x3C,0x00,0x00,0x00,0x00,
 0x00,0x00,0x66,0xFF,0xFF,0xFF,0xFF,0x7E,0x7E,0x3C,0x3C,0x18,0x00,0x00,0x00,0x00,
 0x00,0x00,0x08,0x18,0x3C,0x7E,0xFF,0x7E,0x3C,0x1C,0x08,0x08,0x00,0x00,0x00,0x00,
 0x00,0x00,0x18,0x3C,0x3C,0x7E,0xFF,0xFF,0x76,0x18,0x18,0x18,0x00,0x00,0x00,0x00,
 0x00,0x00,0x08,0x18,0x1C,0x3E,0x7F,0xFF,0xFF,0x76,0x18,0x18,0x00,0x00,0x00,0x00,
 0x00,0x00,0x00,0x00,0x00,0x00,0x00,0x00,0x00,0x00,0x00,0x00,0x00,0x00,0x00,0x00,
 0x00,0x00,0x00,0x00,0x00,0x00,0x00,0x00,0x00,0x00,0x00,0x00,0x00,0x00,0x00,0x00,
 0x00,0x00,0x00,0x00,0x00,0x00,0x00,0x00,0x00,0x00,0x00,0x00,0x00,0x00,0x00,0x00,
 0x00,0x00,0x00,0x00,0x00,0x00,0x00,0x00,0x00,0x00,0x00,0x00,0x00,0x00,0x00,0x00,
 0x00,0x00,0x06,0x0B,0x05,0x3C,0x44,0x82,0x82,0x82,0x44,0x38,0x00,0x00,0x00,0x00,
 0x00,0x00,0x38,0x44,0x82,0x82,0x82,0x44,0x38,0x10,0x7C,0x10,0x00,0x00,0x00,0x00,
 0x00,0x00,0x00,0x00,0x00,0x00,0x00,0x00,0x00,0x00,0x00,0x00,0x00,0x00,0x00,0x00,
 0x00,0x00,0x02,0x0E,0x1A,0x12,0x12,0x12,0x12,0x12,0x1E,0x7C,0xF0,0xE0,0x00,0x00,
 0x00,0x00,0x00,0x00,0x10,0x7E,0x62,0xC3,0x62,0x7E,0x10,0x00,0x00,0x00,0x00,0x00,

 0x00,0x00,0x00,0x00,0x80,0xE0,0xFC,0xFF,0xFC,0xF0,0xE0,0x80,0x00,0x00,0x00,0x00,
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
//----------------------------------------------------------------------- UART ready
0xED, 0x5E, 0xFB, //int mode 2 EI
0x3E, 0x4F, 0xD3, 0x00, //UART <- "O"
0x3E, 0x4B, 0xD3, 0x00, //UART <- "K"
0x3E, 0x0D, 0xD3, 0x00, //UART <- "cr"

0x76, 0x18, 0xFD, //Halt, JR -3
0xFF}; 
uint16_t blocksize_setup = sizeof(BLOCK_SETUP);
//================================================================================ PRIMER
uint16_t offset_primer = 0x7F00;
const byte BLOCK_PRIMER[] = {
0x21, 0x00, 0x00, 0x11, 0x00, 0x80, 0x01, 0x00, 0x30, 0xED, 0xB0, //copy 0x3000 bytes block $0000 -> $8000 (MONITOR CODE)
0x21, 0x20, 0x7F, 0x11, 0x00, 0xFC, 0x01, 0xE0, 0x00, 0xED, 0xB0, //copy 0x00E0 bytes block $7F20 -> $FC00 (CALL table)
0x21, 0x00, 0xA0, //HL <-  Setup address
0x22, 0x02, 0x80, //$8002  <-  HL
0xC3, 0x00, 0x80, //jump $8000
0xFF, 
//---------------------------------------------------- 4BYTE CALL table $FC00 ($7F20)
0x00, 0xC3, 0x00, 0x93, //$FC00 SIO void handler $9300
0x00, 0xC3, 0x03, 0x93, //$FC04 /Pause (input B)*4103 ticks $9303
0x00, 0xC3, 0x0C, 0x93, //$FC09 /TFT_wr_com (input D) $930C
0x00, 0xC3, 0x18, 0x93, //$FC0D /TFT_wr_data (input D) $9318
0x00, 0xC3, 0x24, 0x93, //$FC11 /TFT_rd_data (input D) $9324
0x00, 0xC3, 0x30, 0x93, //$FC14 /TFT_char_cell_set (input D, E) $9330
0x00, 0xC3, 0x89, 0x93, //$FC18 /TFT_char_fill (input A) $9389
0x00, 0xC3, 0xD9, 0x93, //$FC1C /TFT_ch_erase $93D9
0x00, 0xC3, 0x00, 0x94, //$FC20 /SIO read UART data (push ($FE06)) $9400
0x00, 0xC3, 0x0D, 0x94, //$FC24 /UART error print $940D
0x00, 0xC3, 0x3A, 0x94, //$FC28 /SIO read PS/2 data (push $HL) $943A
0x00, 0xC3, 0x00, 0x80, //$FC2C reset
0x00, 0xC3, 0x00, 0x95, //$FC30 /Hex parse (input DE output A) $9500
0x00, 0xC3, 0x3C, 0x95, //$FC34 /Hex print (input A) $953C
0x00, 0xC3, 0x66, 0x95, //$FC38 /Syntax error $9566
0x00, 0xC3, 0x85, 0x95, //$FC3C /Cmdline parser  $9585
0x00, 0xC3, 0x00, 0x80, //$FC40 reset
0x00, 0xC3, 0x00, 0x80, //$FC44 reset
0x00, 0xC3, 0x00, 0x80, //$FC48 reset
0x00, 0xC3, 0x00, 0x80, //$FC4C reset
0x00, 0xC3, 0x00, 0x97, //$FC50 "clr" $9700
0x00, 0xC3, 0x7E, 0x97, //$FC54 "dump " $977E
0x00, 0xC3, 0xE9, 0x97, //$FC58 "send " $97E9
0x00, 0xC3, 0x2E, 0x98, //$FC5C "load " $982E
0x00, 0xC3, 0x69, 0x98, //$FC60 "move " $9869
0x00, 0xC3, 0xB0, 0x98, //$FC64 "jump " $98B0
0x00, 0xC3, 0xCA, 0x98, //$FC68 "exec " $98CA
0x00, 0xC3, 0xFF, 0x98, //$FC6C "sysl " $98FF
0x00, 0xC3, 0x45, 0x99, //$FC70 "sysh " $9945
0x00, 0xC3, 0x8D, 0x99, //$FC74 "out " $998D
0x00, 0xC3, 0xA6, 0x99, //$FC78 "inp " $99A6
0x00, 0xC3, 0xC0, 0x99, //$FC7C "crc7 " $99C0
0x00, 0xC3, 0xFA, 0x99, //$FC80 "sdi " $99FA
0x00, 0xC3, 0x00, 0x80, //$FC84 reset
0x00, 0xC3, 0x00, 0x80, //$FC88 reset
0x00, 0xC3, 0x00, 0x80, //$FC8C reset
0x00, 0xC3, 0x00, 0x80, //$FC90 reset
0x00, 0xC3, 0x00, 0x80, //$FC94 reset
0x00, 0xC3, 0x00, 0x80, //$FC98 reset
0x00, 0xC3, 0x00, 0x80, //$FC9C reset
0x00, 0xC3, 0x00, 0x9B, //$FCA0 crc7_add [input BC last byte pointer] $9B00
0x00, 0xC3, 0x3D, 0x9B, //$FCA4 SD wr byte [input HL] $9B3D
0x00, 0xC3, 0xBF, 0x9B, //$FCA8 SD rd byte [output (HL)] $9BBF
0xFF};
uint16_t blocksize_primer = sizeof(BLOCK_PRIMER);

////================================================================================
//                                                                      ARDUINO MEGA code
////================================================================================
#define READ 39   //OE#
#define WRITE 29  //WE# also LED
#define BUTTON 26
const char ADDR[] = {46,44,42,40, 38,36,34,32, 33,35,41,37, 30,31,28,43}; //addr pins; pin43 = CE#
const char DATA[] = {48,50,52,53, 51,49,47,45}; //data pins
char report[15];
char output[15];
int ButtonState;
uint16_t bytesWritten = 0;

bool EEPROMtype = 0; //0 - AT28C256-15PU; 1 - FM1808-70-P <<<<<<<<<<<<<<<<< EEPROM type select
uint16_t WriteDelay = EEPROMtype ? 0 : 10; //in milliseconds
//--------------------------------------------------------------read/write functions definition
uint8_t readEEPROM(uint16_t address) {
  uint8_t data = 0;
  for(uint8_t n=0; n<16; n++) digitalWrite(ADDR[n], bitRead(address, n)); //set address pins + CE# ON for addr < 0x8000
  digitalWrite(READ, 0);  //OE# on
  __asm__ __volatile__ ("nop"); //data setup time
  for(uint8_t n=0; n<8; n++) data = (data<<1) | digitalRead(DATA[7-n]); //read data pins
  digitalWrite(ADDR[15], 1);  //CE# off
  digitalWrite(READ, 1);  //OE# off
  __asm__ __volatile__ ("nop"); //data setup time
  return data;
}

void writeEEPROM(uint16_t address, uint8_t data) {
  for(uint8_t n=0; n<16; n++) digitalWrite(ADDR[n], bitRead(address, n)); //set address pins + CE# ON for addr < 0x8000
  digitalWrite(WRITE, 0);  //WE# on
  __asm__ __volatile__ ("nop"); //addr hold time
  for(int n=0; n<8; n++) digitalWrite(DATA[n], bitRead(data, n)); //set data pins
  __asm__ __volatile__ ("nop"); //data setup time
  digitalWrite(ADDR[15], 1);  //CE# off
  __asm__ __volatile__ ("nop"); //data hold time
  digitalWrite(WRITE, 1);     //WE# off
  delay(WriteDelay);  //AT28C256-15PU write cycle finalization
  __asm__ __volatile__ ("nop");
}

void writePageEEPROM(uint16_t startAddress, uint8_t data, uint16_t length) {  //writes to AT28C256-15PU up to 64 bytes
  for(int i=0; i<length; i++) {
    uint16_t address = startAddress + i;
    for(uint8_t n=0; n<16; n++) digitalWrite(ADDR[n], bitRead(address, n)); //set address pins + CE# ON for addr < 0x8000
    for(int n=0; n<8; n++) digitalWrite(DATA[n], bitRead(data, n)); //set data pins
    digitalWrite(WRITE, 0);
    __asm__ __volatile__ ("nop");
    digitalWrite(WRITE, 1);
  }
  delay(WriteDelay);  //AT28C256-15PU write cycle finalization
  digitalWrite(ADDR[15], 1);  //CE# off
}

void writeBufferEEPROM(uint16_t startAddress, uint8_t data, uint16_t totalLength) { //writes large buffer of dummy bytes
  if(!EEPROMtype) {  //0 - AT28C256-15PU
    bytesWritten = 0;
    while(bytesWritten < totalLength) {
      uint16_t maxInPage = 64 - ((startAddress + bytesWritten) % 64);
      uint16_t currentBatch = min(maxInPage, totalLength - bytesWritten);
      writePageEEPROM(startAddress + bytesWritten, data, currentBatch);
      bytesWritten += currentBatch;
    }
  }
  else if(EEPROMtype = 1) { //1 - FM1808-70-P
    for(uint16_t j=0; j<totalLength; j++) {writeEEPROM(startAddress + j, data); bytesWritten++;}
  }
}
//------------------------------------------------------------Main code
void setup() {
  for(uint8_t n=0; n<16; n++) pinMode(ADDR[n], OUTPUT);
  for(uint8_t n=0; n<8; n++) pinMode(DATA[n], INPUT);
  pinMode(READ, OUTPUT);
  pinMode(WRITE, OUTPUT);
  pinMode(BUTTON, INPUT);

  digitalWrite(ADDR[15], 1);  //CE# off
  digitalWrite(READ, 1);      //OE# off
  digitalWrite(WRITE, 1);     //WE# off
  Serial.begin(115200);
}

void loop() {
  unsigned int addr_in = 0;
  if(!digitalRead(BUTTON)) {
    for(uint8_t n=0; n<8; n++) pinMode(DATA[n], OUTPUT);
    bytesWritten = 0;
    //----------------------------------------Write dummy bytes
    Serial.println("writing dummy bytes");
    writeBufferEEPROM(0x0000, 0xff, 0x8000);
    //----------------------------------------Write ZEUS firmware
    Serial.println("writing Font Table");
    for(uint16_t j=0; j<blocksize_font; j++) {writeEEPROM(offset_font + j, FONT_TABLE[j]); bytesWritten++;}
    Serial.println("writing Scan Table");
    for(uint16_t j=0; j<blocksize_scan; j++) {writeEEPROM(offset_scan + j, SCAN_TABLE[j]); bytesWritten++;}

    Serial.println("writing Page 0");
    for(uint16_t j=0; j<blocksize_0; j++) {writeEEPROM(offset_0 + j, BLOCK_0[j]); bytesWritten++;}
    Serial.println("writing IntVecs");
    for(uint16_t j=0; j<blocksize_intvec; j++) {writeEEPROM(offset_intvec + j, INTVEC_TABLE[j]); bytesWritten++;}
    Serial.println("writing BIOs");
    for(uint16_t j=0; j<blocksize_bios; j++) {writeEEPROM(offset_bios + j, BLOCK_BIOs[j]); bytesWritten++;}

    Serial.println("writing Parser");
    for(uint16_t j=0; j<blocksize_parser; j++) {writeEEPROM(offset_parser + j, BLOCK_PARSER[j]); bytesWritten++;}
    Serial.println("writing CMDs");
    for(uint16_t j=0; j<blocksize_cmds; j++) {writeEEPROM(offset_cmds + j, BLOCK_CMDs[j]); bytesWritten++;}
    Serial.println("writing SD");
    for(uint16_t j=0; j<blocksize_sd; j++) {writeEEPROM(offset_sd + j, BLOCK_SD[j]); bytesWritten++;}

    Serial.println("writing Setup");
    for(uint16_t j=0; j<blocksize_setup; j++) {writeEEPROM(offset_setup + j, BLOCK_SETUP[j]); bytesWritten++;}
    Serial.println("writing Primer");
    for(uint16_t j=0; j<blocksize_primer; j++) {writeEEPROM(offset_primer + j, BLOCK_PRIMER[j]); bytesWritten++;}
    //----------------------------------------
    for(uint8_t n=0; n<8; n++) pinMode(DATA[n], INPUT);
    sprintf(report, "0x%04x bytes written", bytesWritten);
    Serial.println(report);
    delay(1000);
  }
  //-------------------------1 byte read with Arduino IDE Serial Monitor (set No Line Ending, 115200 baud)
  if(Serial.available()) {
    addr_in = uint16_t(Serial.parseInt());
    byte data1 = readEEPROM(addr_in);
    sprintf(output, "%04x %02x", addr_in, data1); Serial.println(output);
  }
}
